Mouse-Unit-07/hardware-motherboard/README.md

# Hardware Motherboard

- Hardware reference files for the micromouse motherboard
- Includes:
  - Schematic pdf's
  - Layout pdf's
  - Mechanical drawing pdf's
  - Design explanation documentation
