Mouse-Unit-07/hardware-motherboard/design-explanation/power/power-explanation.md

# Power Design Explanation

- Notes regarding motherboard power design choices and specs.

## Index

- [Power Tree Diagram](#power-tree-diagram)
- [3V7 Vacuum Power](#3v7-vacuum-power)
- [12V Wheel Motor Power](#12v-wheel-motor-power)
- [3V3 Power](#3v3-power)
- [5V Power](#5v-power)
- [Switching vs Linear Regulators](#switching-vs-linear-regulators)
- [Battery Selection](#battery-selection)
- [Power Management](#power-management)
- [PCB Traces](#pcb-traces)
- [Electrical Protection](#electrical-protection)
- [Archived Ideas](#archived-ideas)

## Power Tree Diagram

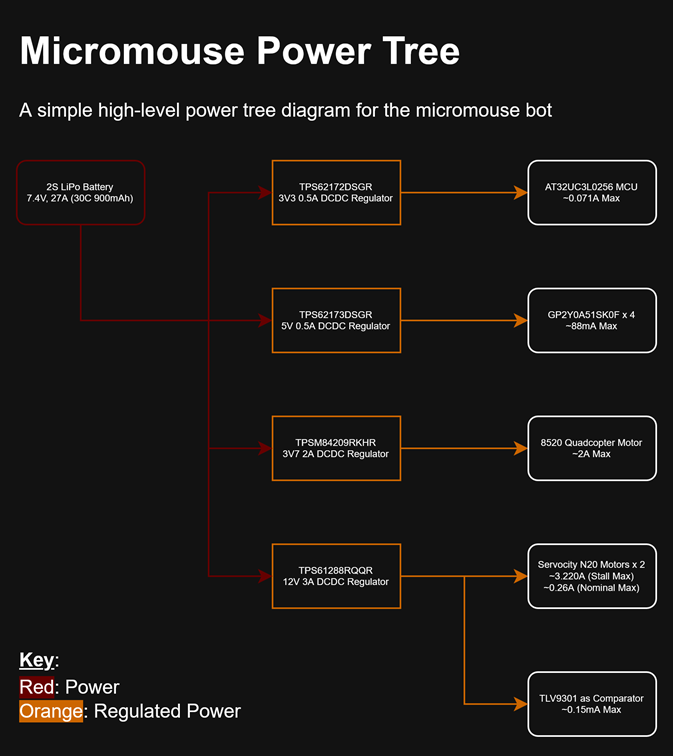
[picture p8: design-explanation/power/_images/power-explanation/micromouse-power-tree.drawio.png]
micromouse-power-tree.drawio
- 
  - Simple/high-level power tree diagram showing battery -> regulators -> components powered

## 3V7 Vacuum Power

- ~2A is ideal for a 8520 quadcopter motor
  - Experiment done here: https://notblackmagic.com/projects/motor-test-stand/
- Regulator selection
  - TI generated circuit: https://webench.ti.com/appinfo/webench/scripts/SDP.cgi?ID=3EACC4ED5253923B
  - 3V7, 2A circuit

## 12V Wheel Motor Power

- ServoCity's [Premium N20 Gear Motor (5:1 Ratio, 4900 RPM, with Encoder)](https://www.servocity.com/4900-rpm-micro-gear-motor-w-encoder/)
  - Demands 1.6A on stall, and 12V nominal
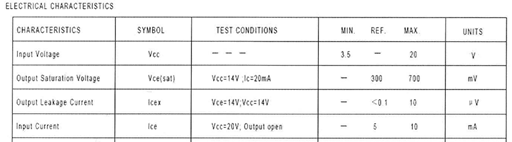
[picture p9: design-explanation/power/_images/power-explanation/servocity-encoder-current.png]
servocity-encoder-current
  - 
    - Encoders demand 10mA max
  - 1.6A * 2 + 10mA * 2 = 3.220A needed
    - ...But this is if we want to consistently support stall current
    - Nominal is much less, at 120mA per motor- there's no need to provide the full 1.6A per motor
- Regulator selection
  - TI generated circuit tool: https://webench.ti.com/appinfo/webench/scripts/SDP.cgi?ID=AA12043C39DD7B4B
  - 12V, 3A circuit

## 3V3 Power

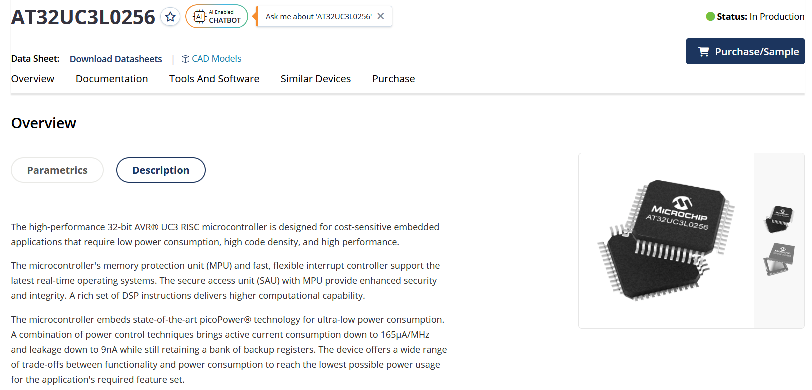
[picture p10: design-explanation/power/_images/power-explanation/at32uc3l0256-current.png]
at32uc3l0256-current
- 
  - Datasheet here: https://ww1.microchip.com/downloads/en/DeviceDoc/Atmel-32145-32-bit-Flash-MCU-UCL0_datasheet.pdf
  - 165uA/MHz at 50MHz is 8.25mA max current draw
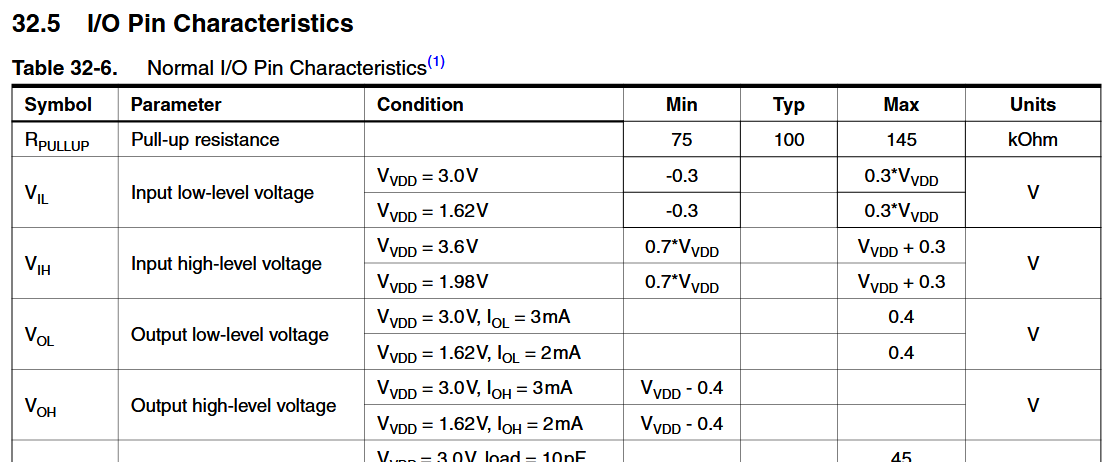
[picture p11: design-explanation/power/_images/power-explanation/at32uc3l0256-io-draw.png]
at32uc3l0256-io-draw
- 
  - IO pins sink 3mA per pin, assuming we're using them safely w/ each device:
    - USART RX, TX
    - LED x4
    - Configuration pushbutton
    - JTAG: TDI, TCK, TDO, TMS
    - Wheel motor drive pins: 4 direction pins + 2 pwm pin, STBY, CLD
    - Vacuum MOSFET drive pin
    - Regulator enable pin
  - 21 pins * 3mA = 63mA total
- Total current:
  - 63mA + 8.25mA = 71.25mA total
- Regulator selection
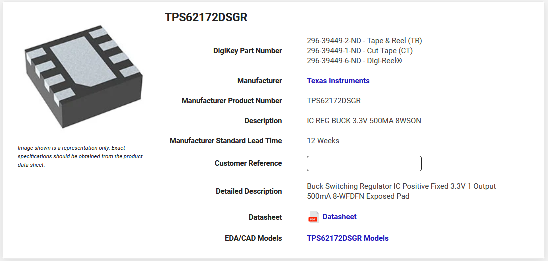
[picture p12: design-explanation/power/_images/power-explanation/3v3-regulator.png]
3v3-regulator
  - 
  - TI's TPS62172DSGR
  - 3V3 500mA switching regulator
  - Datasheet here: [TI Link](https://www.ti.com/lit/ds/symlink/tps62171.pdf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)

## 5V Power

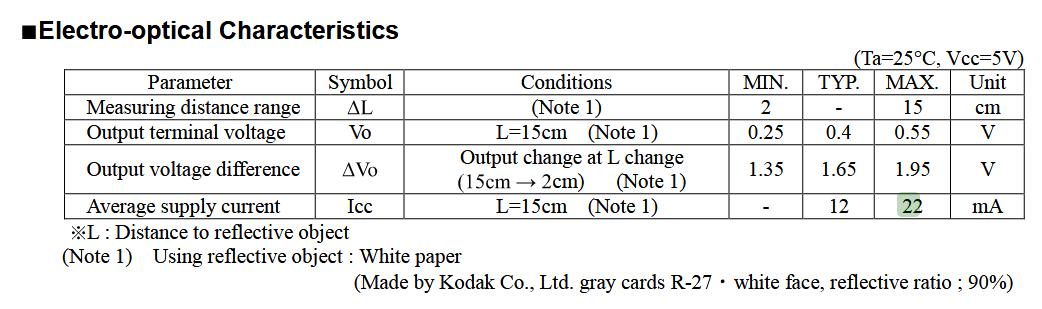
[picture p13: design-explanation/power/_images/power-explanation/GP2Y0A51SK0F-current.png]
GP2Y0A51SK0F-current
- 
  - Each sensor draws 22mA max, so 4 of them makes a total of 88mA max
- Regulator selection
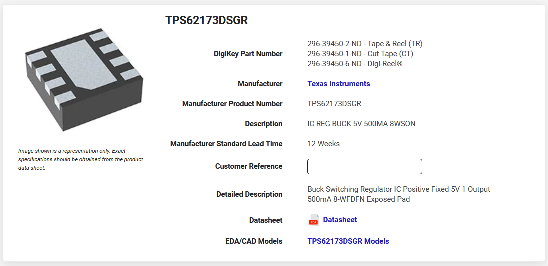
[picture p14: design-explanation/power/_images/power-explanation/5v-regulator.png]
5v-regulator
  - 
  - TI's TPS62173DSGR
  - 5V 500mA switching regulator
  - Datasheet here: [TI Link](https://www.ti.com/lit/ds/symlink/tps62171.pdf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)

## Switching vs Linear Regulators

- Switching regulators are the way to go: https://www.rohm.com/electronics-basics/dc-dc-converters/linear-vs-switching-regulators
  - More details in _The Art of Electronics_ too
- Texas Instruments
  - TI provides a fantastic tool to generate power circuits: https://webench.ti.com/power-designer/switching-regulator
  - TI provides the best datasheets to begin w/ anyway even if you were to manually design a regulator circuit

## Battery Selection

- Battery type
  - LiPo is the best, as per University of Nevada: https://www.physics.unlv.edu/~bill/ecg497/Drew_Tondra_report.pdf
    - Best for performance and rechargeability
    - Smallest form factor 2S LiPo battery chosen on Amazon
    - LiPo analysis video: https://www.youtube.com/watch?v=Lk7wzVYmXSA
    - Understanding LiPo specs: https://www.rchelicopterfun.com/lipo-battery-ratings.html
- Current draw
  - Most RC car LiPo batteries are capable of providing high current
  - We need at least 6A to comfortably drive the micromouse
  - LiPo batteries' capacity multiplier tells us how much current the battery can safely discharge continuously
    - 900 mAh 30C means 27A max current draw
    - 900 mAh at 6A current draw means 9 minutes of activity

```
Total current dischargeable calculation:
900 mAh, 30C rating
900 mA * 30 = 27A dischargeable continuously

Micromouse active time calculation:
900 mAh, 6A draw max
0.9Ah / 6A = 9 minutes
```

## Power Management

- Enable signal
  - Every switching regulator, except the 3V3 regulator, has an enable signal that can be toggled by the MCU
- Battery voltage comparator
  - LM393 dual comparator IC installed for low battery voltage (warning and failure) detection
  - TL431 2.495V voltage reference used for each comparator
  - Each of the comparators light up an indicator LED when thresholds are crossed
  - The failure comparator output is AND'ed w/ a small rocker switch output to drive mouse on/off PMOS- mouse only turns on if battery is OK and rocker switch is in "on" position

```

battery warning threshold comparator voltage divider:
- R1 = 180k, R2 = 100k
Vnode = Vbat * (100 / (180 / 100)) = 0.357 * Vbat
2.495V reference / 0.357 = 6.9V warning threshold

battery failure threshold comparator voltage divider:
- R1 = 160k, R2 = 100k
Vnode = Vbat * (100 / (160 / 100)) = 0.384 * Vbat
2.495V reference / 0.384 = 6.487V failure threshold

```

## PCB Traces

- Even if your regulator circuit can provide 5A, 35 mil traces can only carry 3A
- Use Saturn PCB Design tool to ensure that traces are wide enough to carry the desired current

## Electrical Protection

- TVS clamping diode
  - "transient voltage suppression" diode installed across entire mouse / battery to clamp
  - 10V reverse standoff, 11.1V breakdown, 35.3A, 600W diode clamps any spikes
- PMOS high-side "power pak" load switch
  - Load switch to the entire mouse for smooth on/off, reverse polarity protection
  - Handles up to -20V Vds max, 35A
  - This allows us to avoid a physical high DC current switches to turn on the whole mouse
  - Zener diode installed from source to gate to clamp up to 12V on Vgs
- Battery to regulator input diode
  - IEEE Berkely mentions they encountered an issue w/ current flowing from MCU to regulator: https://ieee.berkeley.edu/micromouse-lab-5/
  - Added to prevent reverse current from regulator to battery
  - 1V voltage drop, 6A standard rectifier between battery and all switching regulators
- Multi-Stage decoupling
  - Varying capacitors of differing capacitance to absorb noise and suppress spikes
  - Low capacitance -> high frequency spikes
  - High capacitance -> low frequency bulk decoupling
- Flyback diodes
  - Why we need these
    - Inductors store energy in a magnetic field while current flows
    - Turning off a motor causes the motor's magnetic field to collapse
    - Inductors resist changes in current, and try to keep current flowing- this causes high voltage spike in the reverse direction across the inductor
    - To safely dissipate excess power, there needs to be a diode that breaks down in response to such spikes
  - Diode selection
    - Breakdown voltage of 2-3 times normal voltage is good
    - Schottky diodes are good for
      - Low forward drop
      - Less heating
      - Faster recovery time if switching is fast
- Order of connecting components to ground
  - Electronics stack exchange thread: https://electronics.stackexchange.com/questions/458538/feeding-microcontroller-and-linear-actuators-motors-with-the-same-power-supply
  - Noisy components should be as close as possible to the power supply ground to mitigate ground loops and noise
- Fuse
  - 10A fuse for entire mouse, provided a rough 6A consumption max
  - 125% of circuit's normal operating current is good rule of thumb
- Bulk capacitor
  - 470uF 25V bulk capacitor x2 for entire mouse
  - Good rule of thumb is:
    - 100uF per A of max load current for general cases
    - 200~470uF per A for high-power and noisier circuits

## Archived Ideas

- Full-on BMS circuit
  - Would be cool to get battery SOH and SOC w/ coulomb counting IC, but requires more hardware and involved schemes
  - Archived due to complexity
- Current & voltage monitoring
  - Requires more pins from MCU and extra hardware (shunt resistors, sensing IC's)
  - Archived for now until crucial features are complete
