Mouse-Unit-07/hardware-motherboard/design-explanation/_images/overview/Mouse 7.0 3D render.png

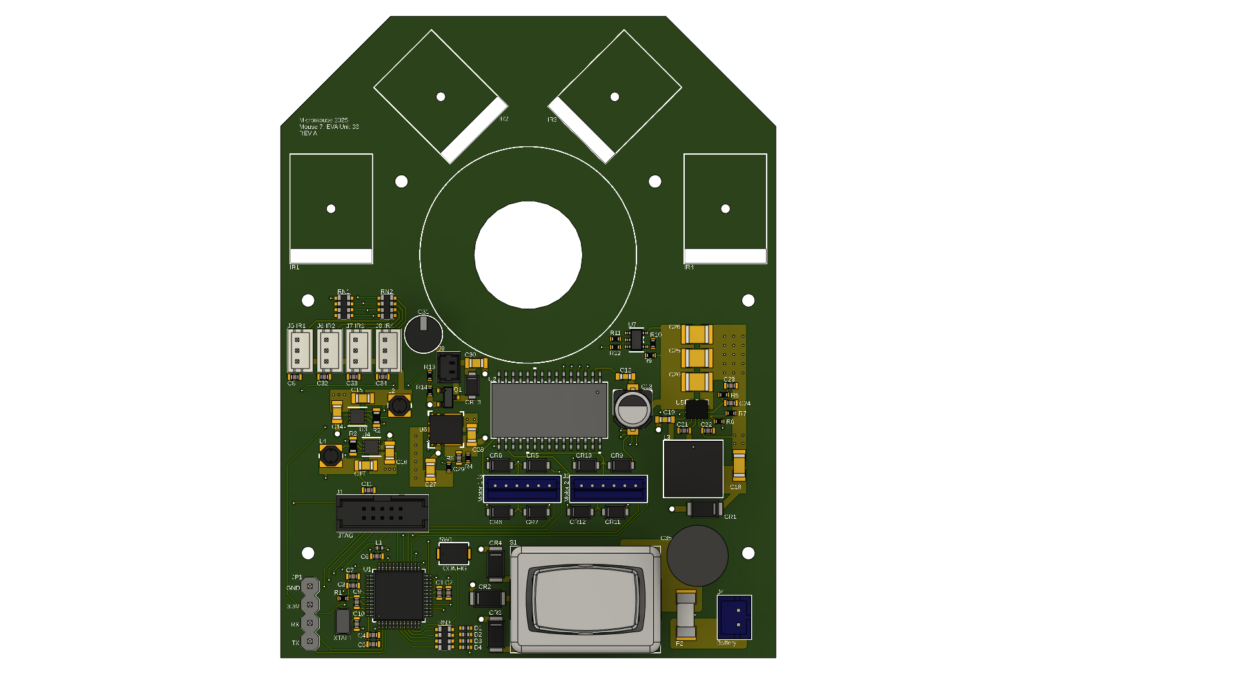
design-explanation/_images/overview/Mouse 7.0 3D render.png
