Mouse-Unit-07/hardware-motherboard/design-explanation/_images/overview/power-circuit.png

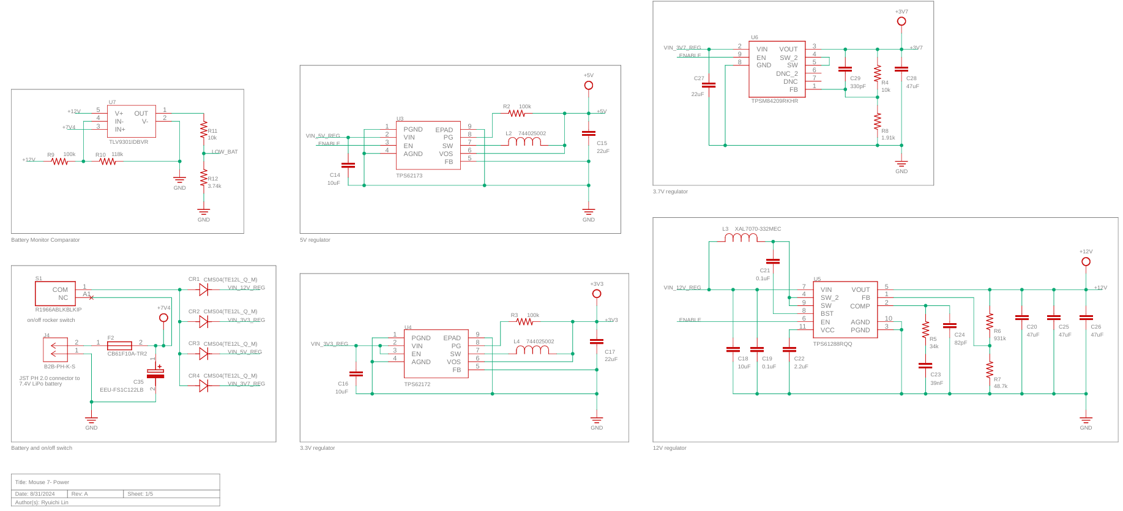
design-explanation/_images/overview/power-circuit.png
