Mouse-Unit-07/hardware-motherboard/design-explanation/_images/overview/vacuum-motor-driver-circuit.png

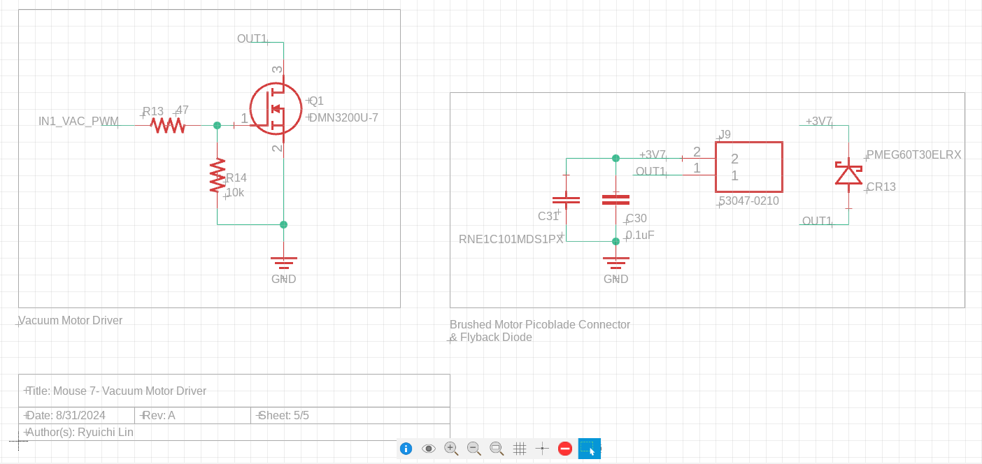
design-explanation/_images/overview/vacuum-motor-driver-circuit.png
