Mouse-Unit-07/hardware-motherboard/design-explanation/_images/overview/wheel-motor-driver.png

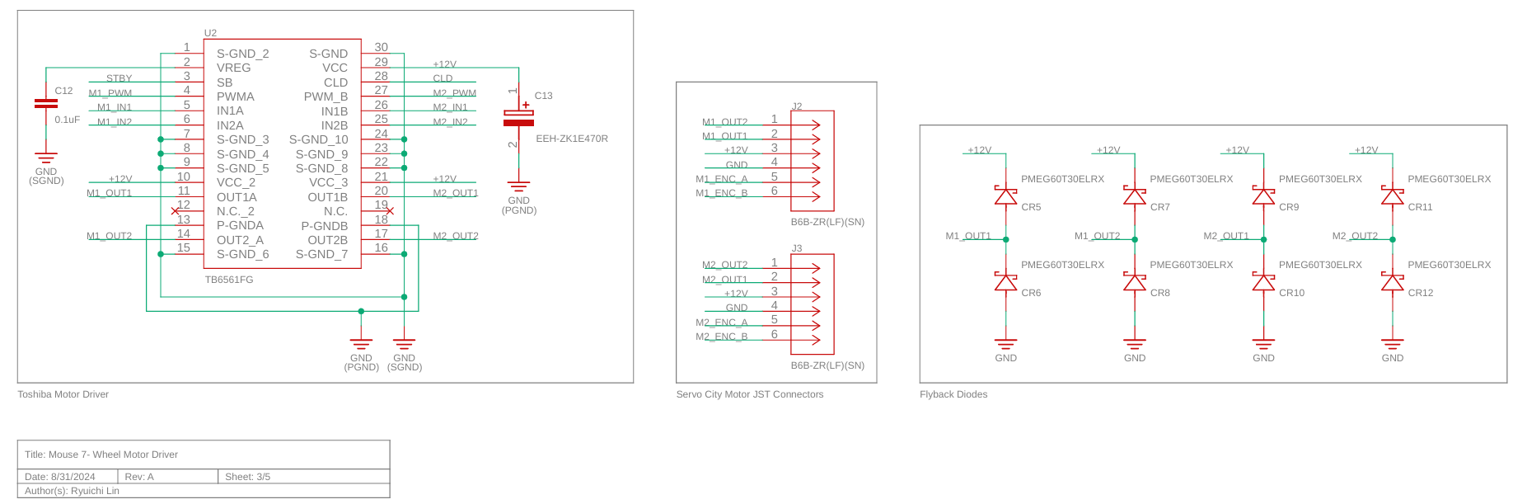
design-explanation/_images/overview/wheel-motor-driver.png
