Mouse-Unit-07/hardware-motherboard/design-explanation/infrared-sensors/_images/infrared-sensor-explanation/sharp-sensor-output-graph.png

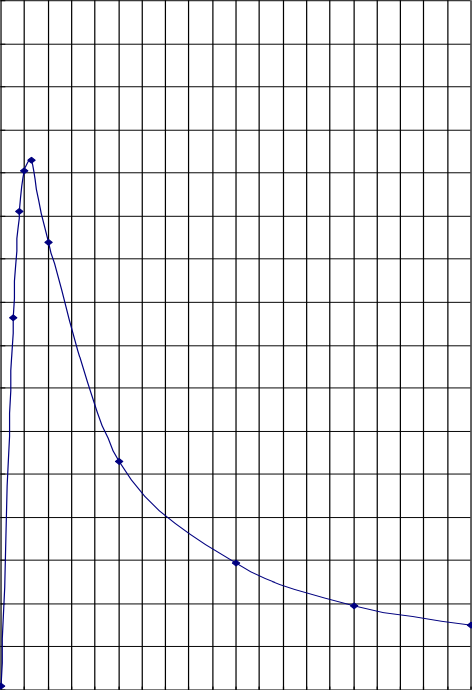
design-explanation/infrared-sensors/_images/infrared-sensor-explanation/sharp-sensor-output-graph.png
