Mouse-Unit-07/hardware-motherboard/bill-of-materials/motherboard-BOM.csv

Category | Vendor | Item Number | Item Description | Quantity Per Package | Cost Per Package | Number of Packages | Item Total Cost | Part Link | Symbol, Layout, & 3D Model Link | Comments | Designation on Mouse 7.0 Test | Designation on Mouse 7.0 PCB
Power | Amazon | B096G4D6ZX | URGENEX 7.4V Lipo Battery 2S 30C 900mAh Rechargeable Lipo Battery with PH2.0 Plug Compatible with Most 1/10, 1/16, 1/18, 1/24 Scale RC Cars Trucks | 2 | $19.99 | 1 | $19.99 | https://www.amazon.com/URGENEX-Battery-900mAh-Rechargeable-Campatibal/dp/B096G4D6ZX |  | - 7.4V LiPo battery, 900mAh, 46g, 30C - JST PH 2.0 pitch 2 position for power, 3 position for charging - 53mm x 16mm x 29mm (l x h x w)
 | Amazon | B01MCZE2HM | 460pcs 2.54mm JST-XH Connector Kit with 2.54mm Female Pin Header and 2/3 / 4/5 / 6 Pin Housing Connector Adapter Plug (JST Connector Kit) | 460 | $10.99 | 1 | $10.99 | https://amazon.com/gp/product/B01MCZE2HM/ref=ppx_yo_dt_b_search_asin_title?ie=UTF8&psc=1 | https://app.ultralibrarian.com/details/cd91410a-50c2-11eb-9033-0a34d6323d74/JST/B3B-XH-A-LF-SN-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 | - XH 2.54mm JST connector 3 position pack both male and female TH - need the female connector | new
 | Digikey | CMS04(TE12LQM)CT-ND | DIODE SCHOTTKY 30V 5A M-FLAT | 1 | $0.76 | 4 | $3.04 | https://www.digikey.com/en/products/detail/toshiba-semiconductor-and-storage/CMS04-TE12L-Q-M/871534 | https://app.ultralibrarian.com/details/873d4c59-1bbb-11ea-a124-0ad2c9526b44/Toshiba-Electronic-Devices-Storage-Corp-/CMS04-TE12L-Q-M-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 | - schottky diode for everything except vacuum that needs 5A - prevents up to 30V and allows 5A to pass - for 3.3V, 5V, 12V, and 3.2V regulators - small 370mV forward drop
 | Digikey | 296-53563-1-ND | DC DC CONVERTER 1.2-6V | 1 | $3.48 | 1 | $3.48 | https://www.digikey.com/en/products/detail/texas-instruments/TPSM84209RKHR/10273205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 | https://app.ultralibrarian.com/details/72767a0a-9a13-11e9-ab3a-0a3560a4cccc/Texas-Instruments/TPSM84209RKHR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 | - 3.7V 2A regulator for vacuum motor - schematic generated w/ TI tool: HERE HERE
 | Digikey | 445-7665-1-ND | CAP CER 22UF 10V X5R 0805 | 1 | $0.39 | 1 | $0.78 | https://www.digikey.com/en/products/detail/tdk-corporation/C2012X5R1A226M125AB/2733100 | n/a | - Cin for vacuum fan regulator circuit - 0805 package - 22uF
 | Digikey | 445-8239-1-ND | CAP CER 47UF 10V X5R 0805 | 1 | $0.79 | 1 | $2.37 | https://www.digikey.com/en/products/detail/tdk-corporation/C2012X5R1A476M125AC/2812455 | n/a | - Cout for vacuum fan regulator circuit - 0805 package - 47uF
 | Digikey | 399-C0402C331J5JAC7867CT-ND | CAP CER 330PF 50V U2J 0402 | 1 | $0.24 | 1 | $0.24 | https://www.digikey.com/en/products/detail/kemet/C0402C331J5JAC7867/6176500 | n/a | - Cff for vacuum fan regulator circuit - 0402 package - 330pF
 | Digikey | 541-10.0KLCT-ND | RES SMD 10K OHM 1% 1/16W 0402 | 1 | $0.10 | 1 | $0.10 | https://www.digikey.com/en/products/detail/vishay-dale/CRCW040210K0FKED/1178121 | n/a | - Rfbt for vacuum fan regulator circuit - 0402 package - 10k Ohm resistor
 | Digikey | 541-1.91KLCT-ND | RES SMD 1.91K OHM 1% 1/16W 0402 | 1 | $0.10 | 1 | $0.10 | https://www.digikey.com/en/products/detail/vishay-dale/CRCW04021K91FKED/1178037 | n/a | - Rfbb for vacuum fan regulator circuit - 0402 package - 1.91k Ohm resistor
 | Digikey | 296-TPS61288RQQRCT-ND | IC REG BOOST ADJ 15A 11VQFN | 1 | $5.89 | 1 | $5.89 | https://www.digikey.com/en/products/detail/texas-instruments/TPS61288RQQR/13627146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 | https://app.ultralibrarian.com/details/b8fe61ee-f9ad-11ea-b55a-0a34d6323d74/Texas-Instruments/TPS61288RQQR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 | - 12V 3A regulator for wheel motor driver - schematic generated w/ TI tool: https://webench.ti.com/appinfo/webench/scripts/SDP.cgi?ID=AA12043C39DD7B4B
 | Digikey | 445-4042-1-ND | CAP CER 10UF 16V X7R 1206 | 1 | $0.30 | 1 | $0.30 | https://www.digikey.com/en/products/detail/tdk-corporation/C3216X7R1C106K160AC/1965630 | n/a | - Cin for wheel motor regulator circuit - 1206 package - 10uF
 | Digikey | 445-1314-1-ND | CAP CER 0.1UF 50V X7R 0603 | 1 | $0.10 | 1 | $0.10 | https://www.digikey.com/en/products/detail/tdk-corporation/C1608X7R1H104K080AA/513811 | n/a | - Cinx for wheel motor regulator circuit - 0603 package - 0.1uF
 | Coilcraft | XAL7070-332 | XAL7070-332MEC | 1 | $3.25 | 1 | $3.25 | https://www.coilcraft.com/en-us/products/power/shielded-inductors/molded-inductor/xal/xal7070/xal7070-332/ | https://app.ultralibrarian.com/details/c70f84e9-0c17-11ee-9288-0ae0a3b49db5/Coilcraft/XAL7070-332MEC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 | - L1 for wheel motor regulator circuit
 | Digikey | 445-4952-1-ND | CAP CER 0.1UF 16V X7R 0402 | 1 | $0.10 | 1 | $0.10 | https://www.digikey.com/en/products/detail/tdk-corporation/C1005X7R1C104K050BC/2093220 | n/a | - Cbst for wheel motor regulator circuit - 0402 package - 0.1uF
 | Digikey | 445-9097-1-ND | CAP CER 2.2UF 10V X7S 0402 | 1 | $0.29 | 1 | $0.29 | https://www.digikey.com/en/products/detail/tdk-corporation/C1005X7S1A225K050BC/3661557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 | n/a | - Cvcc for wheel motor regulator circuit - 0402 package - 2.2uF
 | Digikey | 541-34.0KLCT-ND | RES SMD 34K OHM 1% 1/16W 0402 | 1 | $0.10 | 1 | $0.10 | https://www.digikey.com/en/products/detail/vishay-dale/CRCW040234K0FKED/1178180 | n/a | - Rcomp for wheel motor regulator circuit - 0402 package - 34k Ohms
 | Digikey | 490-16432-1-ND | CAP CER 0.039UF 16V X7R 0402 | 1 | $0.10 | 1 | $0.10 | https://www.digikey.com/en/products/detail/murata-electronics/GCM155R71C393KA37D/7363176 | n/a | - Ccomp for wheel motor regulator circuit - 0402 package - 39nF
 | Digikey | 399-11256-1-ND | CAP CER 82PF 25V C0G/NP0 0402 | 1 | $0.49 | 1 | $0.49 | https://www.digikey.com/en/products/detail/kemet/CBR04C820F3GAC/4377017 | n/a | - Ccomp2 for wheel motor regulator circuit - 0402 package - 82pF
 | Digikey | 541-931KLCT-ND | RES SMD 931K OHM 1% 1/16W 0402 | 1 | $0.10 | 1 | $0.10 | https://www.digikey.com/en/products/detail/vishay-dale/CRCW0402931KFKED/1178346 | n/a | - Rfbt for wheel motor regulator circuit - 0402 package - 931k Ohms
 | Digikey | 541-48.7KLCT-ND | RES SMD 48.7K OHM 1% 1/16W 0402 | 1 | $0.10 | 1 | $0.10 | https://www.digikey.com/en/products/detail/vishay-dale/CRCW040248K7FKED/1178199 | n/a | - Rfbb for wheel motor regulator circuit - 0402 package - 48.7k Ohms
 | Digikey | 490-16309-1-ND | CAP CER 47UF 16V X6S 1210 | 1 | $0.52 | 3 | $1.56 | https://www.digikey.com/en/products/detail/murata-electronics/GRM32EC81C476KE15K/7363053 | n/a | - Cout for wheel motor regulator circuit - 1210 package - 47uF
 | Digikey | 563-1943-ND | SWITCH ROCKER SPDT 0.4VA 28V | 1 | $3.33 | 1 | $3.33 | https://www.digikey.com/en/products/detail/nidec-components/CF-LD-1DC-AR2W/6008982 | https://app.ultralibrarian.com/details/ee126dc9-75f1-11eb-9033-0a34d6323d74/Nidec-Copal-Electronics/CF-LD-1DC-AR2W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 | - rocker switch for on/off of entire mouse - open-drain w/ pull-up to be AND'ed w/ battery comparator before switching on the mouse PMOS | new
 | Digikey | 283-5179-1-ND | FUSE BRD MNT 10A 125VAC/VDC 2SMD | 1 | $0.91 | 1 | $0.91 | https://www.digikey.com/en/products/detail/eaton-electronics-division/CB61F10A-TR2/3526138 | https://www.mouser.com/ProductDetail/Bussmann-Eaton/CB61F10A-TR2?qs=3W28jC%252BmlM2sYw8RFxQ%2Faw%3D%3D | - 10A fuse for entire mouse - 3A for wheels + 2A for vacuum + 1A for 3.3V + 1A for 5V = 7A
 | Digikey | EEE-FT1E471GP | CAP ALUM 470UF 20% 25V SMD | 1 | $1.30 | 2 | $2.60 | https://www.digikey.com/en/products/detail/panasonic-industry/EEE-FT1E471GP/6048928 | https://app.ultralibrarian.com/details/e4f2a1ee-e257-11ea-8aae-0a34d6323d74/Panasonic/EEH-ZK1E470R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 | - 470uF 25V bulk cap x2 for entire mouse | new
 | Digikey | SMBJ10A-E3/52 | TVS DIODE 10VWM 17VC DO214AA | 1 | $0.56 | 1 | $0.56 | https://www.digikey.com/en/products/detail/vishay-general-semiconductor-diodes-division/SMBJ10A-E3-52/1119202 | https://app.ultralibrarian.com/details/73ddbba1-da83-11eb-9033-0a34d6323d74/Vishay/SMBJ100A-E3-52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 | - 10V reverse standoff, 11.1V breakdown, 35.3A, 600W clamping diode for entire mouse and battery | new
 | Digikey | SI7129DN-T1-GE3 | MOSFET P-CH 30V 35A PPAK1212-8 | 1 | $1.62 | 1 | $1.62 | https://www.digikey.com/en/products/detail/vishay-siliconix/SI7129DN-T1-GE3/2622439 | https://app.ultralibrarian.com/details/ff9c0d9f-480b-11ec-9033-0a34d6323d74/Vishay/SI7129DN-T1-GE3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 | - PMOS "power pak" load switch to the entire mouse for clean on/off, reverse polarity protection | new
 | Digikey | SZMM5Z12VST5G | DIODE ZENER 12V 500MW SOD523 | 1 | $0.23 | 1 | $0.23 | https://www.digikey.com/en/products/detail/onsemi/SZMM5Z12VST5G/25602310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 | https://app.ultralibrarian.com/details/dfcd6d67-c043-11eb-9033-0a34d6323d74/onsemi/SZMM5Z10VT1G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 | - Zener diode placed from mouse on/off PMOS source to gate for protection | new
 | Digikey | 445-9086-1-ND | CAP CER 1UF 16V X6S 0402 | 1 | $0.10 | 1 | $0.10 | https://www.digikey.com/en/products/detail/tdk-corporation/C1005X6S1C105K050BC/3661565 | n/a | - 1uF 0402 used to smooth mouse on/off PMOS gate | new
 | Digikey | 296-39450-1-ND | IC REG BUCK 5V 500MA 8WSON | 1 | $1.36 | 1 | $1.36 | https://www.digikey.com/en/products/detail/texas-instruments/TPS62173DSGR/2833458 | https://app.ultralibrarian.com/details/16ac426d-103f-11e9-ab3a-0a3560a4cccc/Texas-Instruments/TPS62173DSGR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 | - 5V, 500mA switching regulator - used to power Sharp sensors
 | Digikey | 296-39449-1-ND | IC REG BUCK 3.3V 500MA 8WSON | 1 | $1.36 | 1 | $1.36 | https://www.digikey.com/en/products/detail/texas-instruments/TPS62172DSGR/2833456 | https://app.ultralibrarian.com/details/16ac3ea9-103f-11e9-ab3a-0a3560a4cccc/Texas-Instruments/TPS62172DSGR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 | - 3.3V, 500mA switching regulator - used to power MCU
 | Digikey | 445-6857-1-ND | CAP CER 10UF 10V X7R 0805 | 1 | $0.31 | 2 | $0.62 | https://www.digikey.com/en/products/detail/tdk-corporation/C2012X7R1A106K125AC/2619198 | n/a | - 10uF ceramic cap needed for 5V and 3.3V switching regulator - between VIN and PGND (pg 21 pdf of datasheet) - 0805 package
 | Digikey | 445-7665-1-ND | CAP CER 22UF 10V X5R 0805 | 1 | $0.39 | 2 | $0.78 | https://www.digikey.com/en/products/detail/tdk-corporation/C2012X5R1A226M125AB/2733100 | n/a | - 22uF ceramic cap needed for 5V and 3.3V switching regulator - between SW and FB (pg 21 pdf of datasheet)
 | Digikey | 541-100KHCT-ND | RES SMD 100K OHM 1% 1/10W 0603 | 1 | $0.10 | 2 | $0.20 | https://www.digikey.com/en/products/detail/vishay-dale/CRCW0603100KFKEA/1174896 | n/a | - 100k Ohm resistor needed for 5V and 3.3V switching regulator - between SW/VOS and PG (pg 21 pdf of datasheet) - smaller 0603 package
 | Digikey | 732-2613-1-ND | FIXED IND 2.2UH 1.8A 66 MOHM SMD | 1 | $1.64 | 2 | $3.28 | https://www.digikey.com/en/products/detail/w%C3%BCrth-elektronik/744025002/2445620 | https://www.mouser.com/ProductDetail/Wurth-Elektronik/744025002?qs=rS3zZhy2AQOJdJOD4WhGug%3D%3D | - 2.2uH inductor needed for 5V and 3.3V switching regulator - between SW and 100k Ohm resistor (pg 21 pdf of datasheet)
 | Digikey | LM393BIDDFR | IC COMPARATOR 2 GEN PUR TSOT23-8 | 1 | $0.24 | 2 | $0.48 | https://www.digikey.com/en/products/detail/texas-instruments/LM393BIDDFR/13535444 | https://app.ultralibrarian.com/details/41f68c4c-e3b2-11ea-8aae-0a34d6323d74/Texas-Instruments/LM393BIDDFR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 | - 2-36V dual comparator IC for low battery voltage (warning and failure) detection - failure comparator output is AND'ed w/ rocker switch output to drive mouse on/off PMOS | new
 | Digikey | 445-4952-1-ND | CAP CER 0.1UF 16V X7R 0402 | 1 | $0.10 | 1 | $0.10 | https://www.digikey.com/en/products/detail/tdk-corporation/C1005X7R1C104K050BC/2093220 | n/a | - 0.1uF cap for comparator vcc | new (dupe)
 | Digikey | TL431AIDBZR | IC VREF SHUNT ADJ 1% SOT23-3 | 1 | $0.29 | 1 | $0.29 | https://www.digikey.com/en/products/detail/texas-instruments/TL431AIDBZR/686856 | https://app.ultralibrarian.com/details/16778844-103f-11e9-ab3a-0a3560a4cccc/Texas-Instruments/TL431AIDBZR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 | - 2.495V voltage reference for LM393 comparator
 | Digikey | 541-10.0KLCT-ND | RES SMD 10K OHM 1% 1/16W 0402 | 1 | $0.10 | 1 | $0.10 | https://www.digikey.com/en/products/detail/vishay-dale/CRCW040210K0FKED/1178121 | n/a | - 10k Ohm 0402 resistor for voltage reference pull-up | new (dupe)
 | Digikey | 445-4952-1-ND | CAP CER 0.1UF 16V X7R 0402 | 1 | $0.10 | 1 | $0.10 | https://www.digikey.com/en/products/detail/tdk-corporation/C1005X7R1C104K050BC/2093220 | n/a | - 0.1uF cap for voltage reference output | new (dupe)
 | Digikey | SG73P1JTTD104J | RES 100K OHM 5% 1/3W 0603 | 1 | $0.11 | 2 | $0.22 | https://www.digikey.com/en/products/detail/koa-speer-electronics-inc/SG73P1JTTD104J/10190103 | n/a | - 100k 0603 pullup for mouse on/off rocker switch and mouse on/off AND_NODE inverting NMOS | new
 | Digikey | RCS0402100KFKED | RES 100K OHM 1% 1/3W 0402 | 1 | $0.12 | 4 | $0.48 | https://www.digikey.com/en/products/detail/vishay-dale/RCS0402100KFKED/5867045 | n/a | - 100k 0402 Vout pullup and voltage divider R2 for battery voltage comparators | new
 | DIgikey | RCS04022M20FKED | RES 2.2M OHM 1% 1/3W 0402 | 1 | $0.13 | 2 | $0.26 | https://www.digikey.com/en/products/detail/vishay-dale/RCS04022M20FKED/12446349 | n/a | - 2.2M Ohm 0402 feedback resistor for each comparator | new
 | Digikey | 541-10.0KLCT-ND | RES SMD 10K OHM 1% 1/16W 0402 | 1 | $0.10 | 2 | $0.20 | https://www.digikey.com/en/products/detail/vishay-dale/CRCW040210K0FKED/1178121 | n/a | - 10k Ohm 0402 resistor for battery comparator warning and failure indicator LEDs | new (dupe)
 | Digikey | RCS0402180KFKED | RES 180K OHM 1% 1/3W 0402 | 1 | $0.13 | 1 | $0.13 | https://www.digikey.com/en/products/detail/vishay-dale/RCS0402180KFKED/5867941 | n/a | - 180k Ohm 0402 resistor for warning battery comparator voltage divider R1 | new
 | Digikey | ERJ-PA2F1603X | RES 160K OHM 1% 1/5W 0402 | 1 | $0.21 | 1 | $0.21 | https://www.digikey.com/en/products/detail/panasonic-industry/ERJ-PA2F1603X/9814976 | n/a | - 160k Ohm 0402 resistor for failure battery comparator voltage divider R1 | new
 | Digikey | 2N7002-7-F | MOSFET N-CH 60V 115MA SOT23-3 | 1 | $0.20 | 1 | $0.20 | https://www.digikey.com/en/products/detail/diodes-incorporated/2N7002-7-F/717681 | https://app.ultralibrarian.com/details/465b5e17-1794-11ed-b159-0a34d6323d74/Diodes-Inc/2N7002AQ-7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 | - 2N7002 NMOS to invert the open-drain AND_NODE and turn on the mouse on/off PMOS when both rocker switch and battery comparator output HIGH | new
Wheel Motor Related | Digikey | TB6561FG8ELCT-ND | IC MOTOR DRIVER 10V-36V 30SSOP | 1 | $3.51 | 1 | $3.51 | https://www.digikey.com/en/products/detail/toshiba-semiconductor-and-storage/TB6561FG-8-EL/1730056 | https://app.ultralibrarian.com/details/84a3ee1c-5a2c-11eb-9033-0a34d6323d74/Toshiba-Electronic-Devices-Storage-Corp-/TB6561FG-8-EL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 | - H bridge PWM interface brushed motor driver - 10-36V supply, 3A output max, 30-BSOP
 | Digikey | 445-7456-1-ND | CAP CER 0.1UF 50V X5R 0603 | 1 | $0.11 | 1 | $0.11 | https://www.digikey.com/en/products/detail/tdk-corporation/C1608X5R1H104K080AA/2732891 | n/a | - C2 0.1uF cap for 5V output from motor driver - datasheet pg 8: HERE - 0603 package
 | Digikey | P121394CT-ND | CAP ALUM HYB 47UF 20% 25V SMD | 1 | $1.45 | 1 | $1.45 | https://www.digikey.com/en/products/detail/panasonic-electronic-components/EEH-ZK1E470R/6564642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 | https://www.mouser.com/ProductDetail/Panasonic/EEH-ZK1E470R?qs=FNcb6ahWXRxnLCe3Ulph5A%3D%3D | - C1 47uF polymer cap for motor driver supply - datasheet pg 8
 | Servocity | 638103 | Gear Motor with Encoder | 1 | $19.99 | 2 | $39.98 | https://www.servocity.com/4900-rpm-micro-gear-motor-w-encoder/ |  | - Gear motors, 4900rpm w/ encoders - 6 position 1.5 pitch ZH JST
 | Amazon | ASIN: B0D8PS1X3D | 1000 Pcs Tiny Screws for Electronics, M1.6 M1.7 M2 M2.5 M3 Round Head Mini, Replacement Computer Screws, Small Machine Assortment Kit for Laptop Notebook Glasses Repair(1000) | 50 | $8.98 | 1 | $8.98 | https://www.amazon.com/woshilaoDS-Electronics-Replacement-Computer-Assortment/dp/B0D8PS1X3D |  | - M1.6 screws for mounting gear motor to 3D printed mounts - Also for mounting 3D mounts to PCB | new
 | Amazon | B07KY8GK5W | uxcell 10pcs Round Steel Metal Rods, 3mm x 100mm High Speed Steel (HSS) Lathe Bar Stock Tool, for Shaft Gear Drill Lathes Boring Machine Turning Miniature DIY Craft, 10pcs | 10 | $7.49 | 1 | $7.49 | https://www.amazon.com/uxcell-Lathe-Round-Solid-Length/dp/B07KY8GK5W |  | - 3mm shafts to loosen the driving gear before attaching to gear motor | new
 | Pololu | 1087 | Black plastic wheels with silicone tires | 2 | $4.95 | 1 | $4.95 | https://www.pololu.com/product/1087 |  | - Wheels, 32mm diameter, 3mm D output shaft - we'll use just the rubber tire and make a custom wheel
 | Amazon | B09NCCXPGM | CQRobot 100 Sets/800 Pieces 1.5 mm Pitch JST ZH 6-Pin IC Sockets & Plugs Adapter Connector Male and Female Terminal, Crimp DIP Kit. for Industrial Integrated Circuit JST Connector Cable. | 100 | $9.58 | 1 | $9.58 | https://www.amazon.com/CQRobot-Connector-Terminal-Industrial-Integrated/dp/B09NCCXPGM | https://www.jst-mfg.com/product/index.php?series=290 https://app.ultralibrarian.com/details/6e868fff-65ca-11eb-9033-0a34d6323d74/JST/B6B-ZR-LF-SN-?uid=248825 | - JST ZH 6 position male (receptacle) TH connector
 | Amazon | B07FW18RQY | uxcell 683ZZ Ball Bearing 3mm x 7mm x 3mm Double Shielded Deep Groove Bearings, Carbon Steel 20pcs | 20 | $7.99 | 4 | $7.99 | https://www.amazon.com/uxcell-Bearing-Double-Shielded-Bearings/dp/B07FW18RQY?rnid=2470954011&rps=1 |  | - 3mm ball bearings to be embedded into custom wheels
 | Amazon | B0BKRQSMFL | FOLIV 700PCS M3 x 5/6/8/10/12/14/16/18/20/25/30mm Button Hex Head Cap Screws M3 Metric Machine Screws Bolts Nuts Washer Assortment Kit, 10.9 Grade Alloy Steel | 10-50 | $15.29 | 1 | $15.29 | https://www.amazon.com/gp/product/B0BKRQSMFL/ref=ox_sc_act_title_1?smid=A3ILXS83DKRO8O&th=1 |  | - M3 button head screws to serve as wheel axels
 | Digikey | 1727-7806-1-ND | DIODE SCHOTTKY 60V 3A SOD123W | 1 | $0.39 | 8 | $3.12 | https://www.digikey.com/en/products/detail/nexperia-usa-inc/PMEG60T30ELRX/9086223 | https://app.ultralibrarian.com/details/785255d6-6dbf-11ee-9288-0ae0a3b49db5/Nexperia/PMEG60T30ELRX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 | - Flyback diodes for EMF protection
 | Digikey | 1772-4071-ND | ROUND SPACER M3 SS 2MM | 1 | $1.51 | 4 | $6.04 | https://www.digikey.com/en/products/detail/raf-electronic-hardware/M0501-3-SS/10073266 |  | - M3 2mm thick spacers to put between wheel and mount - 4.5mm diameter
 | Pololu | 3407 | Silicone Tire Pair for 32×7mm Pololu Wheels | 2 | $2.35 | 4 | $4.70 | https://www.pololu.com/product/3407 | n/a | - 32mm diameter tires
Vacuum Fan Related | Amazon | B08RMQP6YP | 1.25mm Male and Female Connectors Socket and Plug with Pre-Crimped Cables Compatible with JST Molex PicoBlade 1.25 for Pixhawk Silicone 13cm Wire (Male and Female) | 20 | $18.99 | 1 | $18.99 | https://www.amazon.com/Connectors-Pre-Crimped-Compatible-PicoBlade-Silicone/dp/B08RMQP6YP | n/a | - Molex picoblade connector various positions, - includes 3 position 1.25mm pitch male and female connector, 20 of each - includes 10cm precrimped wire - to be used to extend HGLRC wire
 | Digikey | DMN3200U-7DICT-ND | MOSFET N-CH 30V 2.2A SOT23-3 | 1 | $0.45 | 1 | $0.45 | https://www.digikey.com/en/products/detail/diodes-incorporated/DMN3200U-7/1778821 | https://www.mouser.com/ProductDetail/Diodes-Incorporated/DMN3200U-7?qs=oDfC%252BbpzniwrIf3%2FMV01IQ%3D%3D | - 2.2A 30V MOSFET to switch on/off regulator power to vacuum fan
 | Digikey | P17216CT-ND | RES 47 OHM 1% 1/4W 0402 | 1 | $0.23 | 1 | $0.23 | https://www.digikey.com/en/products/detail/panasonic-electronic-components/ERJ-PA2F47R0X/5402642 | n/a | - 47 Ohm gate resistor for MOSFET to limit surge curernt
 | Digikey | 541-10.0KLCT-ND | RES SMD 10K OHM 1% 1/16W 0402 | 1 | $0.10 | 1 | $0.10 | https://www.digikey.com/en/products/detail/vishay-dale/CRCW040210K0FKED/1178121 | n/a | - 10k Ohm resistor for pulling down input to MOSFET to ensure low - 0402 package
 | Digikey | 493-3813-1-ND | RNE1C101MDS1PX | 1 | $0.76 | 1 | $0.76 | https://www.digikey.com/en/products/detail/nichicon/RNE1C101MDS1PX/2239221 | https://app.ultralibrarian.com/details/8611d1e7-1076-11e9-ab3a-0a3560a4cccc/Nichicon/RNE1C101MDS1PX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 | 100uF capacitor for vacuum fan driver
 | Digikey | 4988-NMC0805X7R104K50TRPFCT-ND | CAP SMT08050.1F50VDC | 1 | $0.24 | 1 | $0.24 | https://www.digikey.com/en/products/detail/nic-components-corp/NMC0805X7R104K50TRPF/18895932 | n/a | - 0.1uF cap for brushless motor driver - 0805 package
 | Amazon | B07CFQMF1M | 8pcs 8520 Motor 8.5x20mm 15000KV Brushed Motors 4CW 4CCW Coreless Motor with JST-1.25 Connector for D JI Ryze Tello 720P Camera WiFi FPV RC Quadcopter M80S E013 Plus Tiny 8X Frame Kit etc | 8 | $18.99 | 1 | $18.99 | https://www.amazon.com/8-5x20mm-15000KV-Coreless-JST-1-25-Connector/dp/B07CFQMF1M?rnid=2470954011&rps=1 | n/a | - 15000KV brushed DC motor for vacuum fan - 2p 1.25mm pitch picoblade connector
 | Digikey | WM1731-ND | CONN HEADER VERT 2POS 1.25MM | 1 | $0.23 | 1 | $0.23 | https://www.digikey.com/en/products/detail/molex/0530470210/242853?s=N4IgTCBcDaIKwGYAMAWA7EsBGJIC6AvkA | - https://app.ultralibrarian.com/details/56453440-d29f-11ea-b5d0-0aebb021a1ea/Molex-Connector-Corporation/530470210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 - https://www.molex.com/en-us/products/part-detail/530470210 | - motor to board connector for vacuum fan - 2p 1.25mm pitch picoblade connector
 | Digikey | 1727-7806-1-ND | DIODE SCHOTTKY 60V 3A SOD123W | 1 | $0.39 | 1 | $0.78 | https://www.digikey.com/en/products/detail/nexperia-usa-inc/PMEG60T30ELRX/9086223 | https://app.ultralibrarian.com/details/785255d6-6dbf-11ee-9288-0ae0a3b49db5/Nexperia/PMEG60T30ELRX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 | - Flyback diodes for EMF protection
Ball Caster, nuts, screws | Amazon | B0BTYDZVM8 | 1 Oz (23 Grams) 3000-CPS Super Glue All Purpose with Anti Clog Cap. Ca Glue - Adhesive SuperGlue. Cyanoacrylate Glue for Hard Plastics, DIY Craft, Metal and Many More | 1 | $6.99 | 1 | $6.99 | https://www.amazon.com/gp/product/B0BTYDZVM8/ref=sw_img_1?smid=A3O523LQQ2NT7Z&th=1 |  | - superglue to attach 3D printed mounts to PCB
IR Sensing | Digikey | 1855-1027-ND | SENSOR OPTICAL 2-15CM ANALOG | 1 | $8.45 | 4 | $33.80 | https://www.digikey.com/en/products/detail/sharp-socle-technology/GP2Y0A51SK0F/4103863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 | https://www.mouser.com/ProductDetail/Sharp-Microelectronics/GP2Y0A51SK0F?qs=Qrpqs4v%252BmsahSKJyPt06pw%3D%3D | - Sharp IR distance sensor 2-15cm - shortest range sharp IR sensor available - connects w/ 3 position ZH JST connector - needs 10uF cap
 | Amazon | B09NC8Y2PK | CQRobot 100 Sets/500 Pieces 1.5 mm Pitch JST ZH 3-Pin IC Sockets & Plugs Adapter Connector Male and Female Terminal, Crimp DIP Kit. for Industrial Integrated Circuit JST Connector Cable. | 50 | $11.99 | 1 | $11.99 | https://www.amazon.com/CQRobot-Connector-Terminal-Industrial-Integrated/dp/B09NC8Y2PK | https://www.jst-mfg.com/product/index.php?series=290 | - JST ZH 1.5 pitch 3 position pack both male and female TH - 50 male, 50 female
 | Digikey | 490-GRM155R61A106ME11DCT-ND | CAP CER 10UF 10V X5R 0402 | 1 | $0.13 | 4 | $0.52 | https://www.digikey.com/en/products/detail/murata-electronics/GRM155R61A106ME11D/12091056 | n/a | - 10uF ceramic capacitor, SMD 0402 - needed for Sharp IR sensors
 | Digikey | CAY16-1001F4LFCT-ND | RES ARRAY 4 RES 1K OHM 1206 | 1 | $0.10 | 1 | $0.10 | https://www.digikey.com/en/products/detail/bourns-inc/CAY16-1001F4LF/2566504 | https://app.ultralibrarian.com/details/ccdadb33-1071-11e9-ab3a-0a3560a4cccc/Bourns-Electronics/CAY16-1001F4LF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 | - R1 resistor array to drop 2.5V max from IR sensor output to 1.8V - 1k Ohm resistor array, 4 resistors
 | Digikey | CAY16-2201F4LFCT-ND | RES ARRAY 4 RES 2.2K OHM 1206 | 1 | $0.10 | 1 | $0.10 | https://www.digikey.com/en/products/detail/bourns-inc/CAY16-2201F4LF/2566534 | https://app.ultralibrarian.com/details/1c159e3e-f9f4-11ed-b159-0a34d6323d74/Bourns-Electronics/CAY16-2201F4LF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 | - R2 resistor to drop 2.5V max from IR sensor output to 1.8V - 2.2k Ohms calculated w/ voltage divider equation - resistor array, 4 resistors
MCU | Digikey | 1175-1733-ND | CONN HEADER VERT 10POS 1.27MM | 1 | $0.68 | 1 | $0.68 | https://www.digikey.com/en/products/detail/cnc-tech/3221-10-0100-00/4878932 | https://www.arrow.com/en/products/3221-10-0100-00/cnc-tech-llc | - 2x5 TH JTAG programming header - small 1.27 pitch w/ key slot and shroud
 | Digikey | 2151-RT3215-32.768-12.5-TR-10PPMCT-ND | CRYSTAL 32.7680KHZ 12.5PF SMD | 1 | $0.42 | 1 | $0.42 | https://www.digikey.com/en/products/detail/raltron-electronics/RT3215-32-768-12-5-TR-10PPM/13151073 | https://app.ultralibrarian.com/details/ce5d9187-838b-11ec-9033-0a34d6323d74/Raltron/RT3215-32-768-12-5-TR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 | - 32.768kHz external crystal
 | Digikey | GJM1555C1H120FB01D | CAP CER 12PF 50V C0G/NP0 0402 | 1 | $0.16 | 2 | $0.32 | https://www.digikey.com/en/products/detail/murata-electronics/GJM1555C1H120FB01D/2592850 | https://app.ultralibrarian.com/details/d28e9410-f5b2-11eb-9033-0a34d6323d74/Murata/GQM1555C2D3R5CB01J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 | - 12pF caps for external crystal - needed on each crystal terminal - 0402 package | new
 | Amazon | B07BJJC3R6 | NOYITO TTL to RS232 Module TTL RS232 Male Female Mutual Conversion Module Serial Level Conversion to SP232 TTL Serial Port Communicates with RS232 Level Device 15KV ESD Protect (Female) | 1 | $7.99 | 1 | $7.99 | https://www.amazon.com/NOYITO-Module-Conversion-Arduino-communicates/dp/B07BJJC3R6?rnid=2470954011&rps=1 | not needed | - TTL to DB-9 (DE-9) translator for serial out
 | Amazon | B0759HSLP1 | OIKWAN USB to RS232, USB Serial Adapter with FTDI Chipset,USB 2.0 to Male DB9 Serial Cable for Windows 11,10, 8, 7, Vista, XP, 2000, Linux and Mac OS(6ft)… | 1 | $11.99 | 1 | $11.99 | https://www.amazon.com/Adapter-Chipset%EF%BC%8CDB9-Serial-Converter-Windows/dp/B0759HSLP1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 | not needed | - DB-9 (DE-9) to USB A for serial out
 | Digikey | AT32UC3L0256-AUT-ND | IC MCU 32BIT 256KB FLASH 48TQFP | 1 | $10.19 | 1 | $10.19 | https://www.digikey.com/en/products/detail/microchip-technology/AT32UC3L0256-AUT/3046397 | https://app.ultralibrarian.com/details/89115949-109b-11e9-ab3a-0a3560a4cccc/Microchip/AT32UC3L0256-AUT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 | - AT32UC3L0256 AVR MCU to replace Arduino - 50MHz, faster than controller above, operates on 3.3V - 12b ADC, PWM, programmed via JTAG and aWire - schematic checklist: HERE
 | Digikey | 490-GRM155R61A106ME11DCT-ND | CAP CER 10UF 10V X5R 0402 | 1 | $0.13 | 1 | $0.13 | https://www.digikey.com/en/products/detail/murata-electronics/GRM155R61A106ME11D/12091056 | n/a | - 10uF capacitor for AT32UC3L0256 VDDin - page 4 of schematic checklist - small 0402 package
 | Digikey | 445-4952-1-ND | CAP CER 0.1UF 16V X7R 0402 | 1 | $0.10 | 3 | $0.30 | https://www.digikey.com/en/products/detail/tdk-corporation/C1005X7R1C104K050BC/2093220 | n/a | - 0.1uf ceramic cap for AT32UC3L0256 VDDin, VDDio, and VDDcore - page 4 of schematic checklist - 0402 package
 | Digikey | 445-9097-1-ND | CAP CER 2.2UF 10V X7S 0402 | 1 | $0.29 | 1 | $0.29 | https://www.digikey.com/en/products/detail/tdk-corporation/C1005X7S1A225K050BC/3661557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 | n/a | - 2.2uF ceramic cap for AT32UC3L0256 VDDio, and VDDcore - page 4 of schematic checklist - 0402 package
 | Digikey | 445-4952-1-ND | CAP CER 0.1UF 16V X7R 0402 | 1 | $0.10 | 2 | $0.10 | https://www.digikey.com/en/products/detail/tdk-corporation/C1005X7R1C104K050BC/2093220 | n/a | - 0.1uF ceramic cap for AT32UC3L0256 VDDana and ADVREF - page 5 of schematic checklist - 0402 package
 | Digikey | 732-74269241152CT-ND | WE-TMSB SMT EMI SUPPRESSION FERR | 1 | $0.13 | 1 | $0.13 | https://www.digikey.com/en/products/detail/w%C3%BCrth-elektronik/74269241152/17830009 | https://app.ultralibrarian.com/details/ab67cd4b-c364-11ed-b159-0a34d6323d74/Wurth-Electronics/74269244182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 | - ferrite bead for for AT32UC3L0256 VDDana and ADVREF - page 5 of schematic checklist, and page 15 on xplained dev board schematic: HERE - 0402 package
 | Digikey | 445-4952-1-ND | CAP CER 0.1UF 16V X7R 0402 | 1 | $0.10 | 1 | $0.10 | https://www.digikey.com/en/products/detail/tdk-corporation/C1005X7R1C104K050BC/2093220 | n/a | - 0.1uF ceramic cap for JTAG on AT32UC3L0256 - 0402 package
 | Digikey | 541-10.0KLCT-ND | RES SMD 10K OHM 1% 1/16W 0402 | 1 | $0.10 | 1 | $0.10 | https://www.digikey.com/en/products/detail/vishay-dale/CRCW040210K0FKED/1178121 | n/a | - 10k resistor for pulling down enable signal - 0402 package
Bluetooth | Sparkfun | SKU: WRL-23287 | SparkFun BlueSMiRF v2 - Headers | 1 | $11.95 | 1 | $11.95 | https://www.sparkfun.com/sparkfun-bluesmirf-v2-headers.html | n/a | - ESP32 bluetooth module from sparkfun to serve as a UART bridge - works out of the box- all we need are 2.54mm pitch pins and a 5V supply
Misc | Digikey | 2449-CS1213AGF160CT-ND | SWITCH TACTILE SPST-NO 0.05A 50V | 1 | $0.40 | 1 | $0.40 | https://www.digikey.com/en/products/detail/cit-relay-and-switch/CS1213AGF160/16607723 | https://app.ultralibrarian.com/details/600608b2-d687-11ed-b159-0a34d6323d74/CIT-Relay-Switch/CS1213AGF260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 | - 3.9mm x 2.9mm smd pushbutton for config - 2mm high
 | Digikey | RCS0402100KFKED | RES 100K OHM 1% 1/3W 0402 | 1 | $0.12 | 4 | $0.48 | https://www.digikey.com/en/products/detail/vishay-dale/RCS0402100KFKED/5867045 | n/a | - 100k 0402 resistor for pushbutton debouncing | new (dupe)
 | Digikey | GRM155R60J474KE19D | GRM155R60J474KE19D | 1 | $0.10 | 1 | $0.10 | https://www.digikey.com/en/products/detail/murata-electronics/GRM155R60J474KE19D/702530 | n/a | - 0.47uF 0402 cap for pushbutton debouncing | new
 | DIgikey | 1N4148W-7-F | DIODE STANDARD 100V 150MA SOD123 | 1 | $0.17 | 1 | $0.17 | https://www.digikey.com/en/products/detail/diodes-incorporated/1N4148W-7-F/814371 | https://app.ultralibrarian.com/details/1598d007-1067-11e9-ab3a-0a3560a4cccc/Diodes-Inc/1N4148W-7-F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 | - small diode for pushbutton debouncing | new
 | Digikey | 754-1105-1-ND | LED YELLOW CLEAR CHIP SMD | 1 | $0.41 | 2 | $0.82 | https://www.digikey.com/en/products/detail/kingbright/APHHS1005SYCK/1747503 | https://app.ultralibrarian.com/details/f21eebf1-5907-11ee-9288-0ae0a3b49db5/Kingbright/APHHS1005CGCK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 | - yellow SMD LED 0402 package for debug, and battery comparator warning indication
 | Digikey | 754-2123-1-ND | LED RED CLEAR 2SMD | 1 | $0.52 | 2 | $1.04 | https://www.digikey.com/en/products/detail/kingbright/APHHS1005LSECK-J3-PF/7318976 | https://app.ultralibrarian.com/details/f21eebf1-5907-11ee-9288-0ae0a3b49db5/Kingbright/APHHS1005CGCK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 | - red SMD LED 0402 package for debug, and battery comparator failure indication
 | Digikey | 754-1503-1-ND | LED GREEN CLEAR CHIP SMD | 1 | $0.70 | 1 | $0.70 | https://www.digikey.com/en/products/detail/kingbright/APHHS1005ZGC/2263569 | https://app.ultralibrarian.com/details/f21eebf1-5907-11ee-9288-0ae0a3b49db5/Kingbright/APHHS1005CGCK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 | - green SMD LED 0402 package for debug
 | Digikey | 754-1504-1-ND | LED BLUE CLEAR CHIP SMD | 1 | $0.51 | 1 | $0.51 | https://www.digikey.com/en/products/detail/kingbright/APHHS1005QBC-D/2263568 | https://app.ultralibrarian.com/details/f21eebf1-5907-11ee-9288-0ae0a3b49db5/Kingbright/APHHS1005CGCK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 | - blue SMD LED 0402 package for debug
 | Digikey | CAY16-2201F4LFCT-ND | RES ARRAY 4 RES 2.2K OHM 1206 | 1 | $0.10 | 1 | $0.10 | https://www.digikey.com/en/products/detail/bourns-inc/CAY16-2201F4LF/2566534 | https://app.ultralibrarian.com/details/1c159e3e-f9f4-11ed-b159-0a34d6323d74/Bourns-Electronics/CAY16-2201F4LF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 | - 2.2k Ohm resistor array, 4 resistors
 | Digikey | 952-2664-1-ND | PC TEST POINT NATURAL | 1 | $0.31 |  | $0.00 | https://www.digikey.com/en/products/detail/harwin-inc/S2751-46R/5250499 | https://www.mouser.com/ProductDetail/Harwin/S2751-46R?qs=DaxoyN%2FvrebM3VuuS3MPNA%3D%3D | - TH testpoint to probe mouse
PCB | JLC PCB | n/a | PCB prototype:Y4-5162408A | 5 | $2.00 | 1 | $2.00 | https://jlcpcb.com/?_ga=2.135028465.1970803033.1675648070-692031392.1675094888 |  | - solid and cheap PCB vendor - no issues so far, purple nice and deep purple
 |  |  |  |  |  | total cost: | #REF!
 |  |  |  |  |  | 116
 | resistors: | https://www.digikey.com/en/products/filter/chip-resistor-surface-mount/52
 | headers: | https://www.digikey.com/en/products/filter/rectangular-connectors/headers-receptacles-female-sockets/315
 | ceramic caps: | https://www.digikey.com/en/products/filter/ceramic-capacitors/60
 | electrolytic caps: | https://www.digikey.com/en/products/filter/aluminum-electrolytic-capacitors/58
 | motor drivers: | https://www.digikey.com/en/products/filter/motor-drivers-controllers/744
 | linear regulators: | https://www.digikey.com/en/products/filter/voltage-regulators-linear/699
 | to-220 heatsinks: | https://www.digikey.com/en/products/filter/thermal/heat-sinks/to-220/219
 | screws: | https://www.digikey.com/en/products/filter/screws-bolts/572
 | nuts: | https://www.digikey.com/en/products/filter/nuts/573
 | MCUs: | https://www.digikey.com/en/products/filter/microcontrollers/685
 | more MCUs: | https://www.digikey.com/en/products/filter/microcontrollers/685
 | IMUs: | https://www.digikey.com/en/products/filter/imus-inertial-measurement-units/567
 | rectifier diodes: | https://www.digikey.com/en/products/filter/single-diodes/280
 | inductors: | https://www.digikey.com/en/products/filter/fixed-inductors/71
 | switching regulators: | https://www.digikey.com/en/products/filter/voltage-regulators-dc-dc-switching-regulators/739
