Mouse-Unit-07/hardware-motherboard/design-explanation/_images/overview/motherboard-components.drawio.png

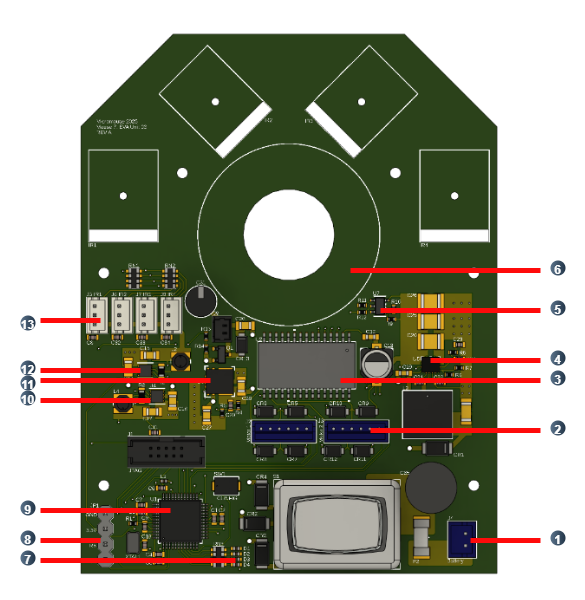
design-explanation/_images/overview/motherboard-components.drawio.png
