Mouse-Unit-07/hardware-motherboard/3d-mounts/wheel mount gears- small gear.3mf

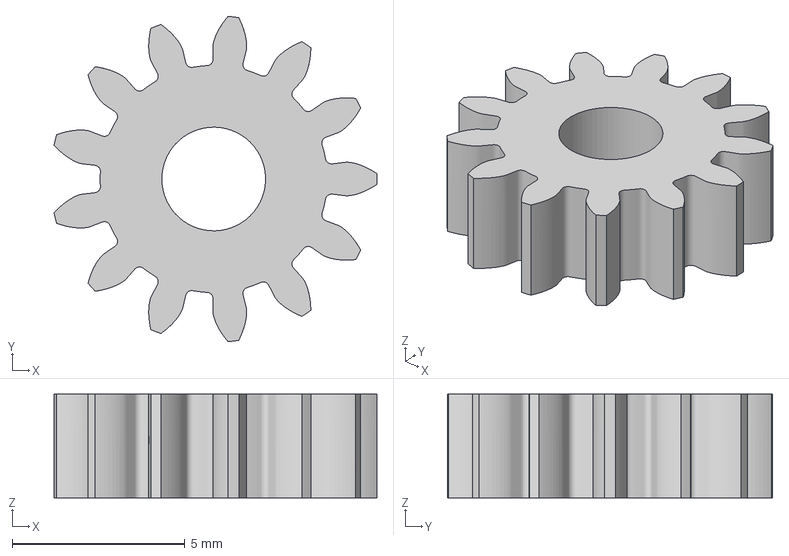
[picture p21: CAD file, 2025-04-27, last stored version]
3d-mounts/wheel mount gears- small gear.3mf
9.35 x 9.41 x 3.00 mm
