Mouse-Unit-07/hardware-motherboard/3d-mounts/wheel mount- left.3mf

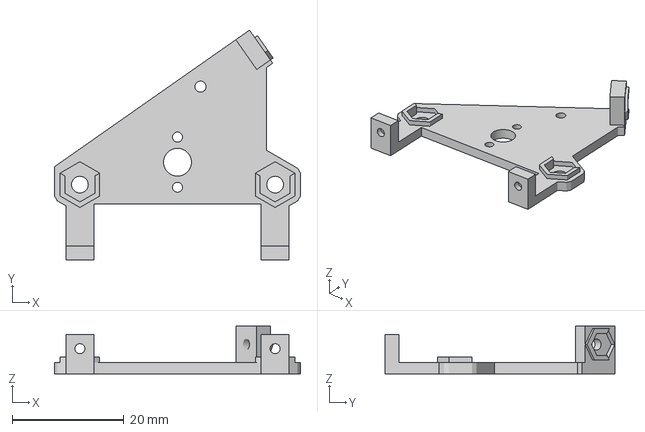
[picture p22: CAD file, 2025-04-27, last stored version]
3d-mounts/wheel mount- left.3mf
44.1 x 41.2 x 8.52 mm
