Mouse-Unit-07/hardware-motherboard/3d-mounts/Battery Mount- 450mAh LiPo.3mf

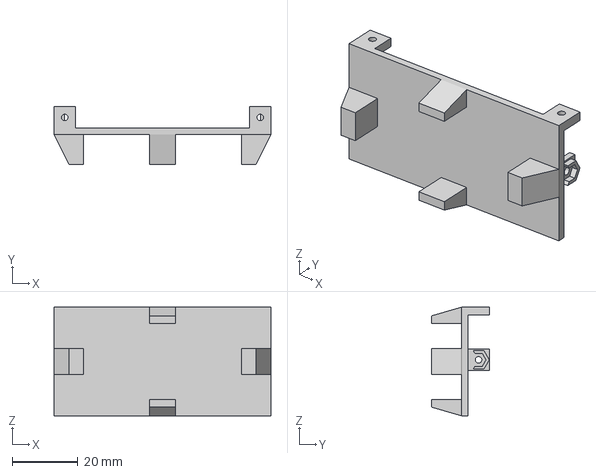
[picture p23: CAD file, 2025-04-27, last stored version]
3d-mounts/Battery Mount- 450mAh LiPo.3mf
66.0 x 17.5 x 33.0 mm
