Mouse-Unit-07/hardware-motherboard/3d-mounts/vacuum motor mount.3mf

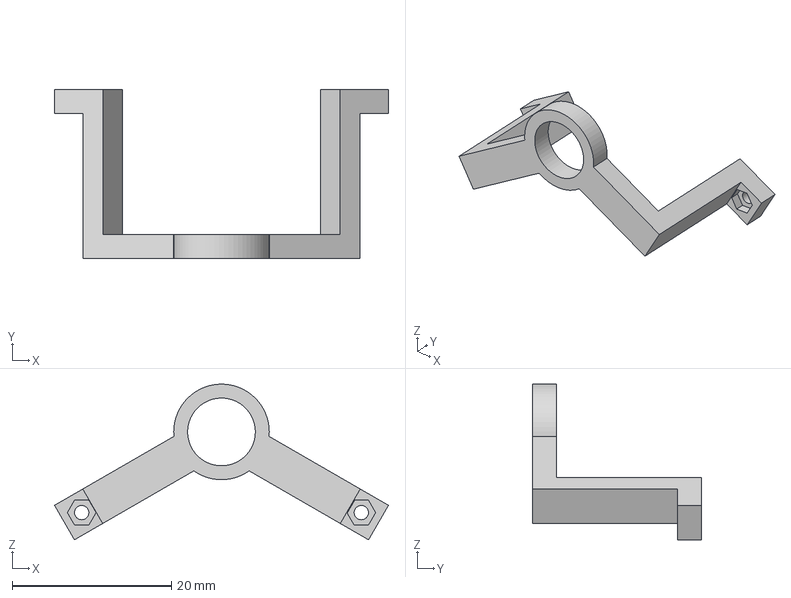
[picture p24: CAD file, 2025-04-27, last stored version]
3d-mounts/vacuum motor mount.3mf
41.9 x 21.2 x 19.5 mm
