Mouse-Unit-07/hardware-motherboard/3d-mounts/vacuum fan.3mf

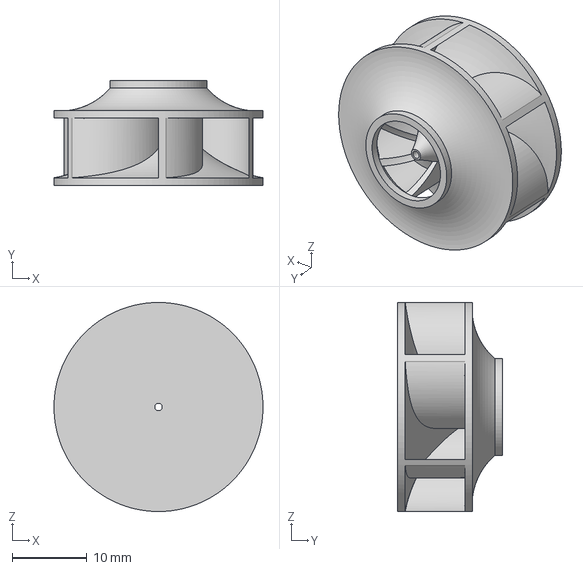
[picture p25: CAD file, 2025-04-27, last stored version]
3d-mounts/vacuum fan.3mf
28.0 x 14.0 x 28.0 mm
