Mouse-Unit-07/hardware-motherboard/3d-mounts/wheel mount gears- large gear.3mf

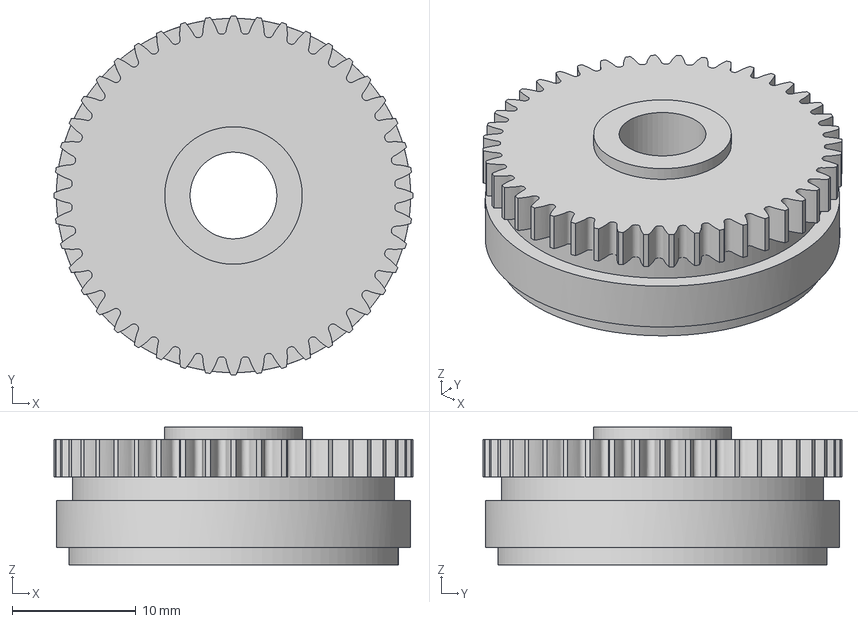
[picture p26: CAD file, 2025-04-27, last stored version]
3d-mounts/wheel mount gears- large gear.3mf
29.0 x 29.0 x 11.1 mm
