Mouse-Unit-07/hardware-motherboard/3d-mounts/sharp sensor mount.3mf

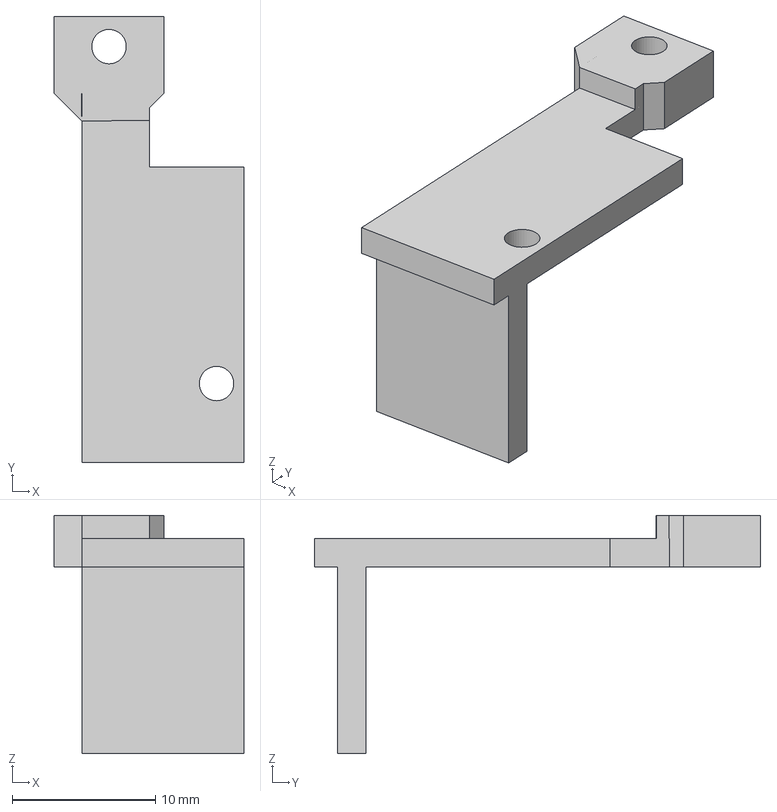
[picture p27: CAD file, 2025-04-27, last stored version]
3d-mounts/sharp sensor mount.3mf
13.2 x 31.1 x 16.6 mm
