Mouse-Unit-07/hardware-motherboard/(list of files, cad)

Other CAD files:
3d-mounts/wheel mount- right.3mf
