Mouse-Unit-07/hardware-motherboard/schematic/mouse-unit-07-schematic-B.pdf

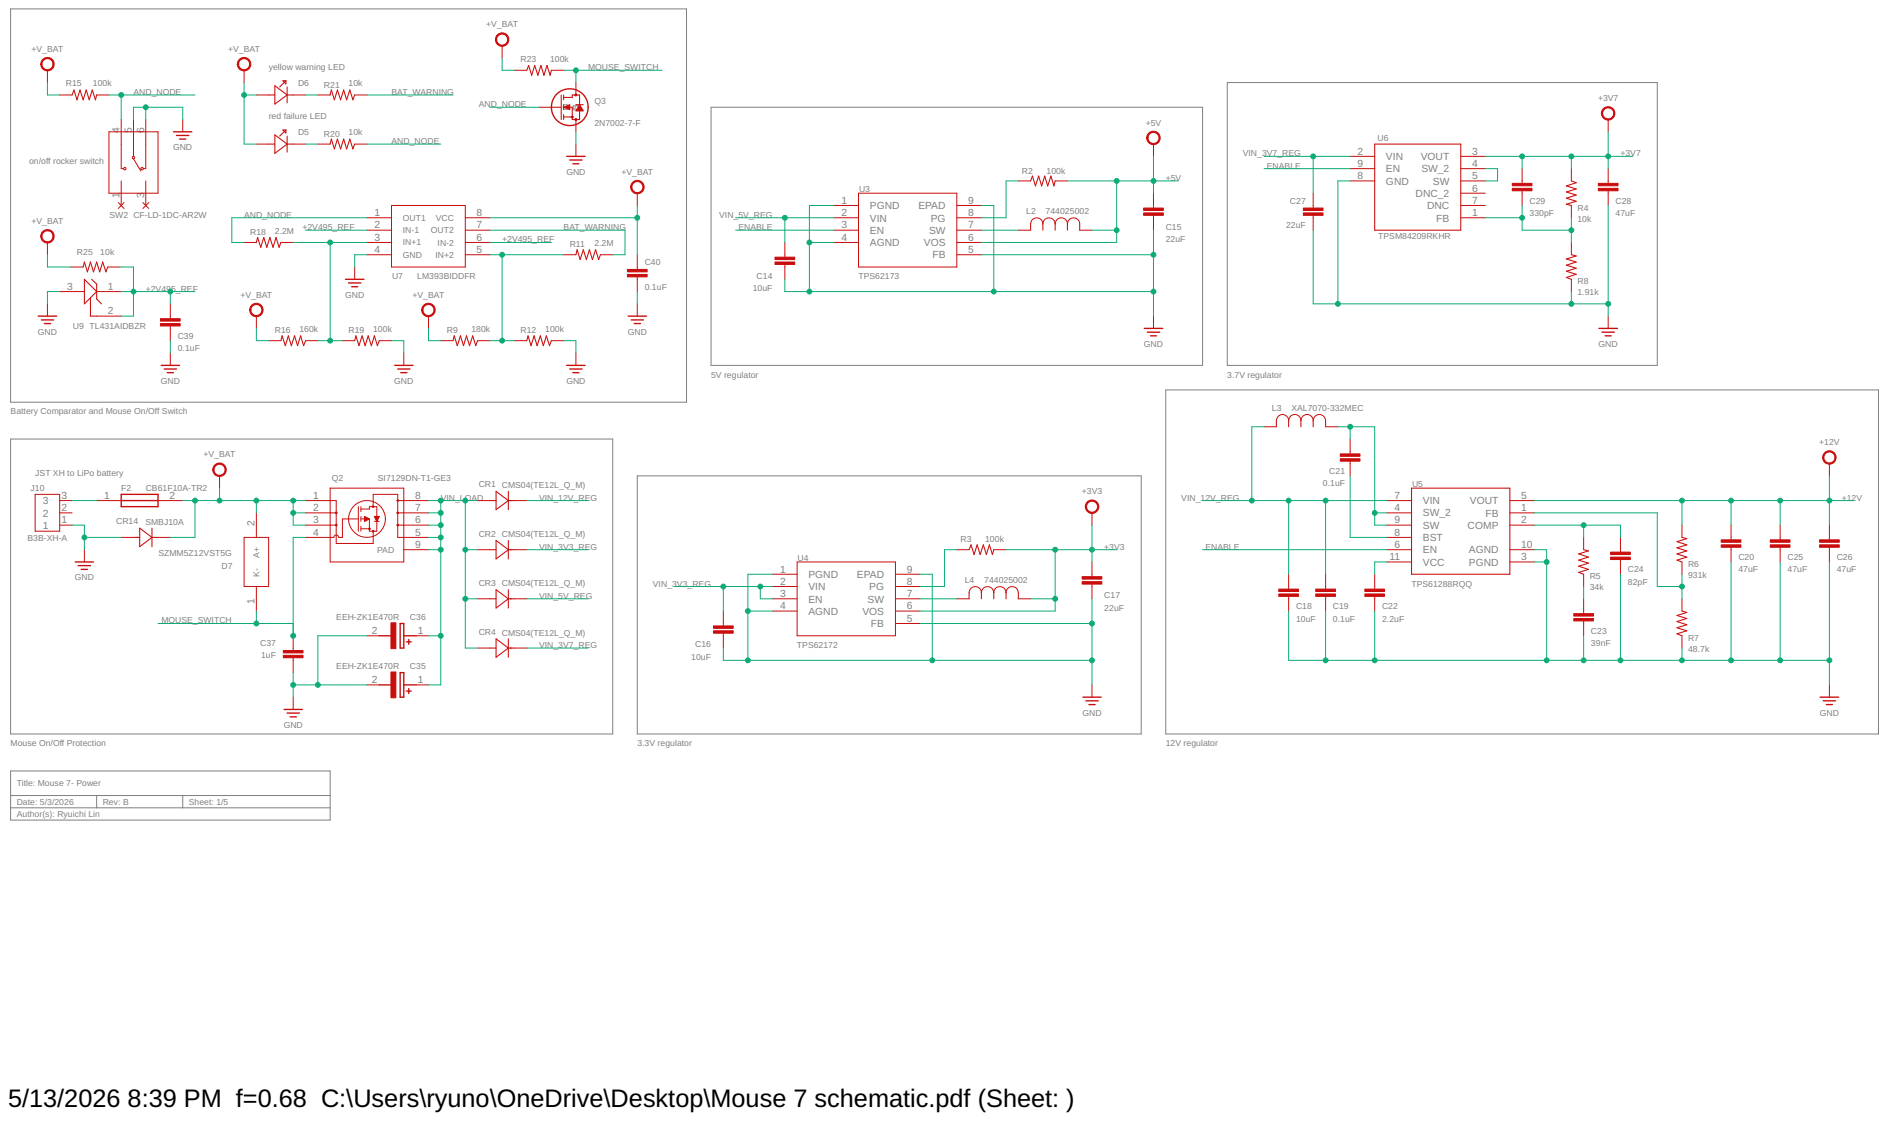
[picture p28: page 1]

on/off rocker switch

3.7V regulator Battery Comparator and Mouse On/Off Switch

5/13/2026 8:39 PM f=0.68 C:\Users\ryuno\OneDrive\Desktop\Mouse 7 schematic.pdf (Sheet: )

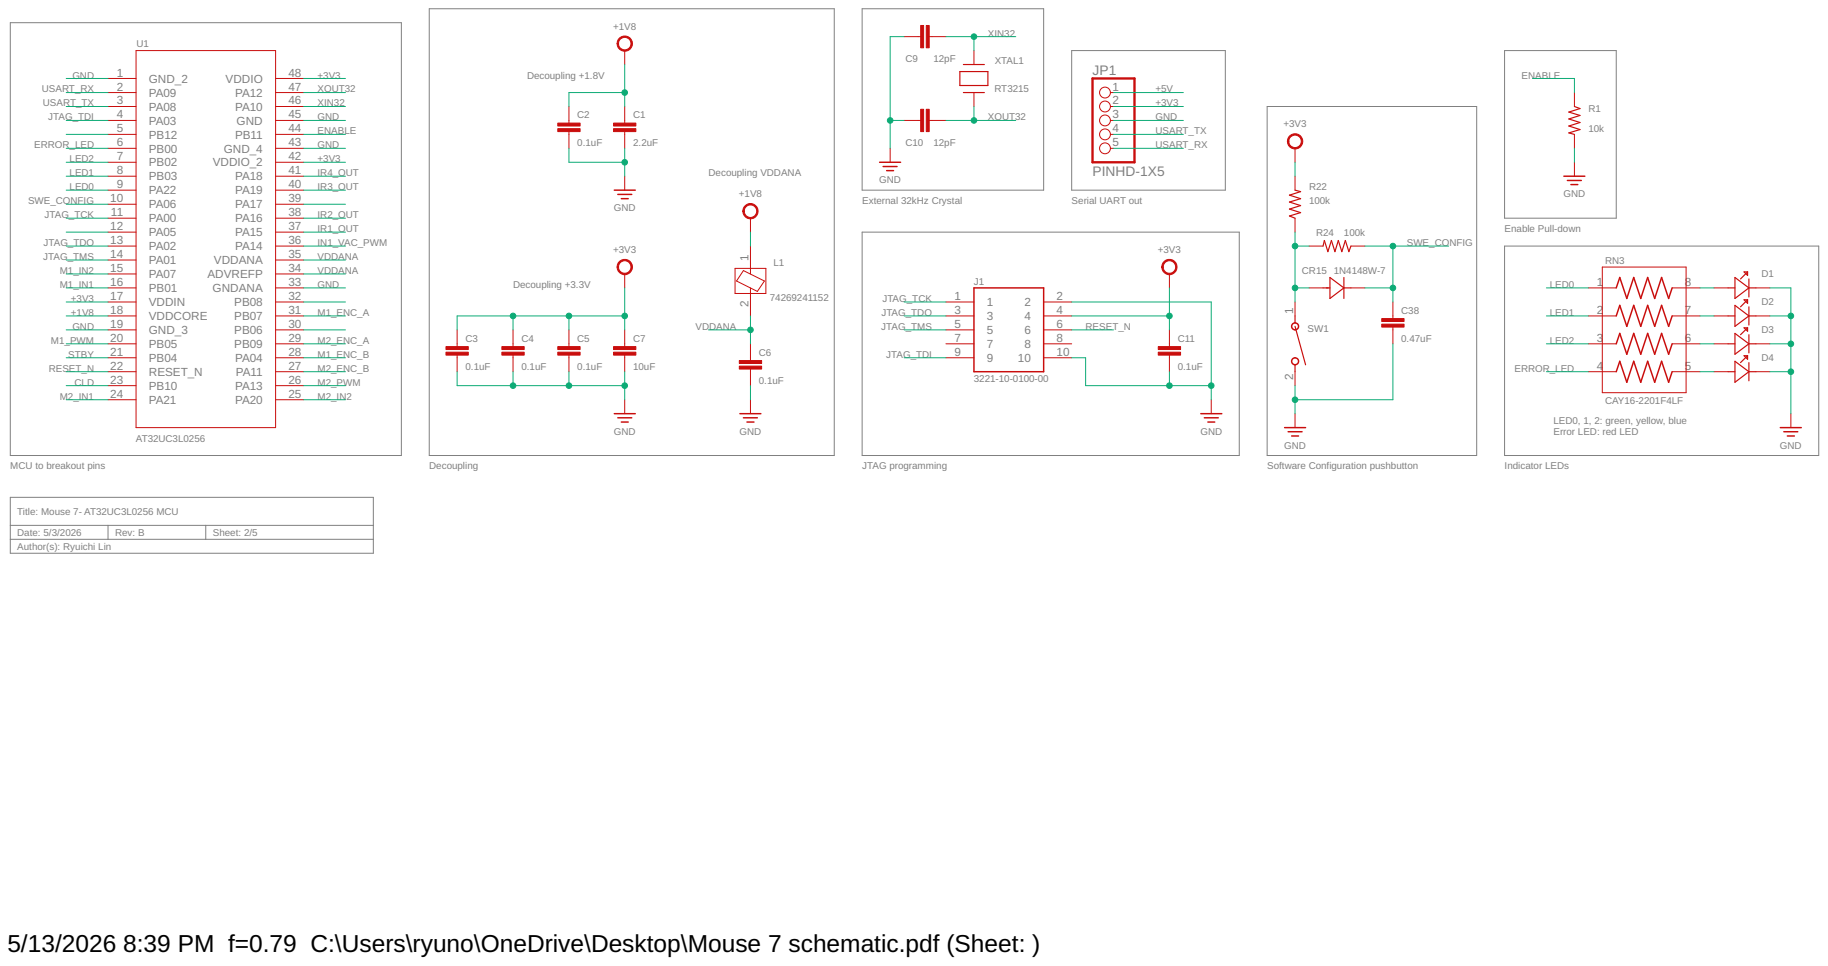
[picture p29: page 2]

MCU to breakout pins

Sheet: 2/5 Author(s): Ryuichi Lin

5/13/2026 8:39 PM f=0.79 C:\Users\ryuno\OneDrive\Desktop\Mouse 7 schematic.pdf (Sheet: )

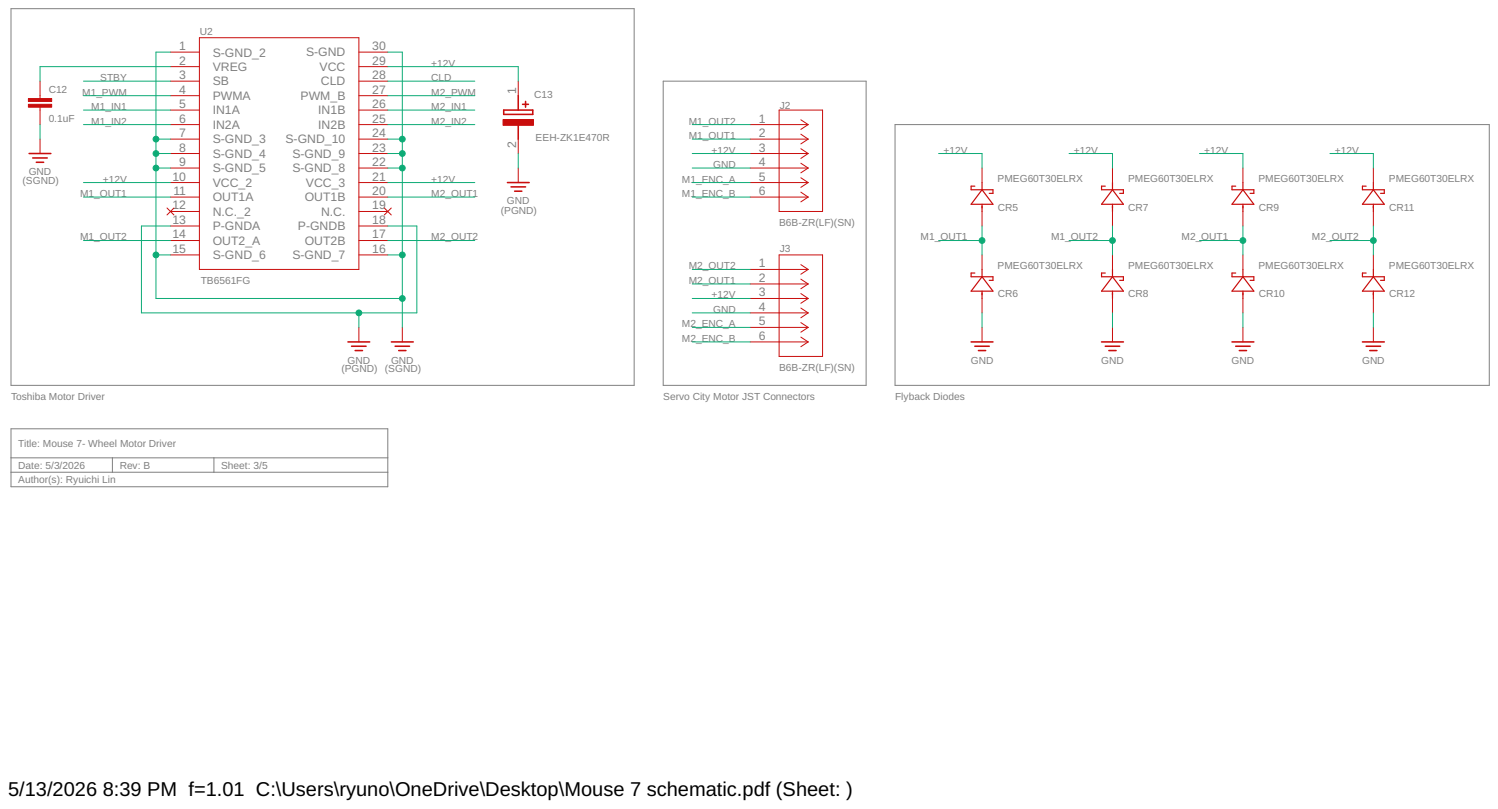
[picture p30: page 3]

5/13/2026 8:39 PM f=1.01 C:\Users\ryuno\OneDrive\Desktop\Mouse 7 schematic.pdf (Sheet: )

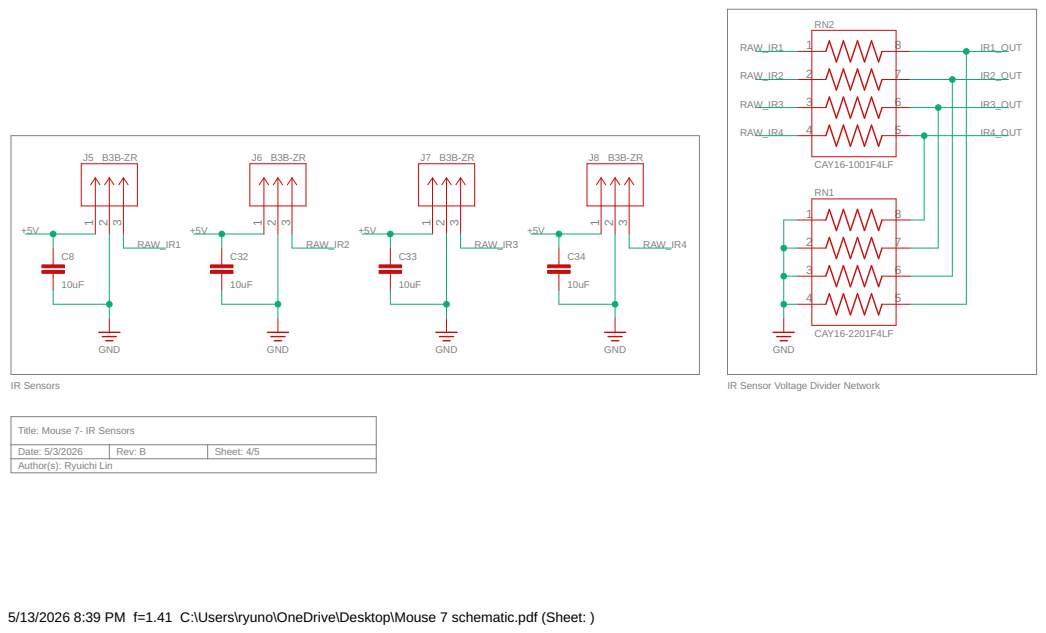
[picture p31: page 4]

5/13/2026 8:39 PM f=1.41 C:\Users\ryuno\OneDrive\Desktop\Mouse 7 schematic.pdf (Sheet: )

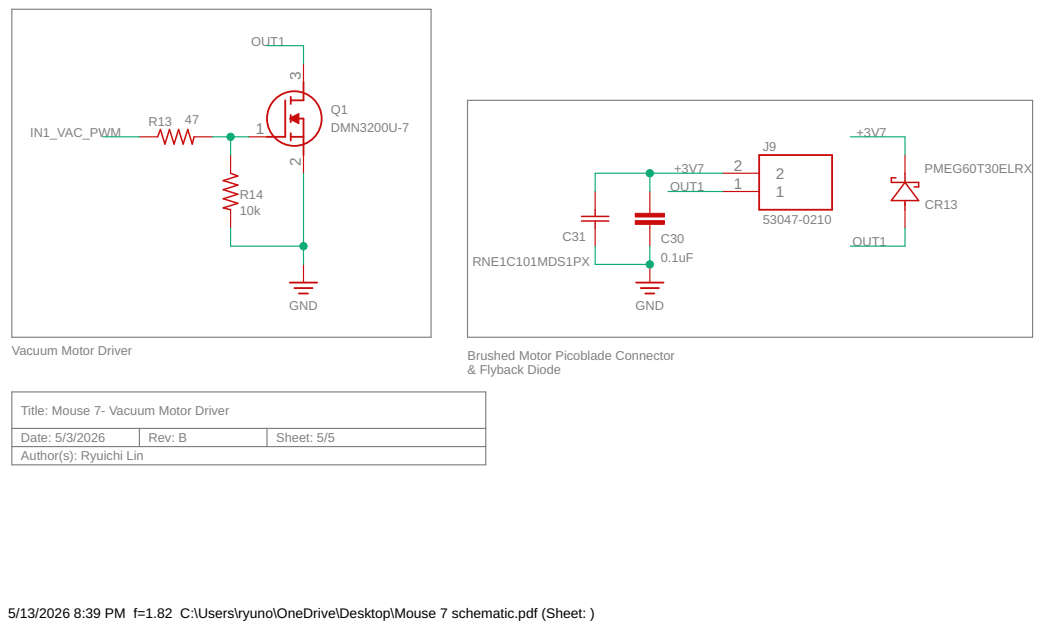
[picture p32: page 5]

Title: Mouse 7- Vacuum Motor Driver
Author(s): Ryuichi Lin

5/13/2026 8:39 PM f=1.82 C:\Users\ryuno\OneDrive\Desktop\Mouse 7 schematic.pdf (Sheet: )
