Mouse-Unit-07/hardware-motherboard/mechanical-drawings/mouse-unit-07-drawing-A.pdf

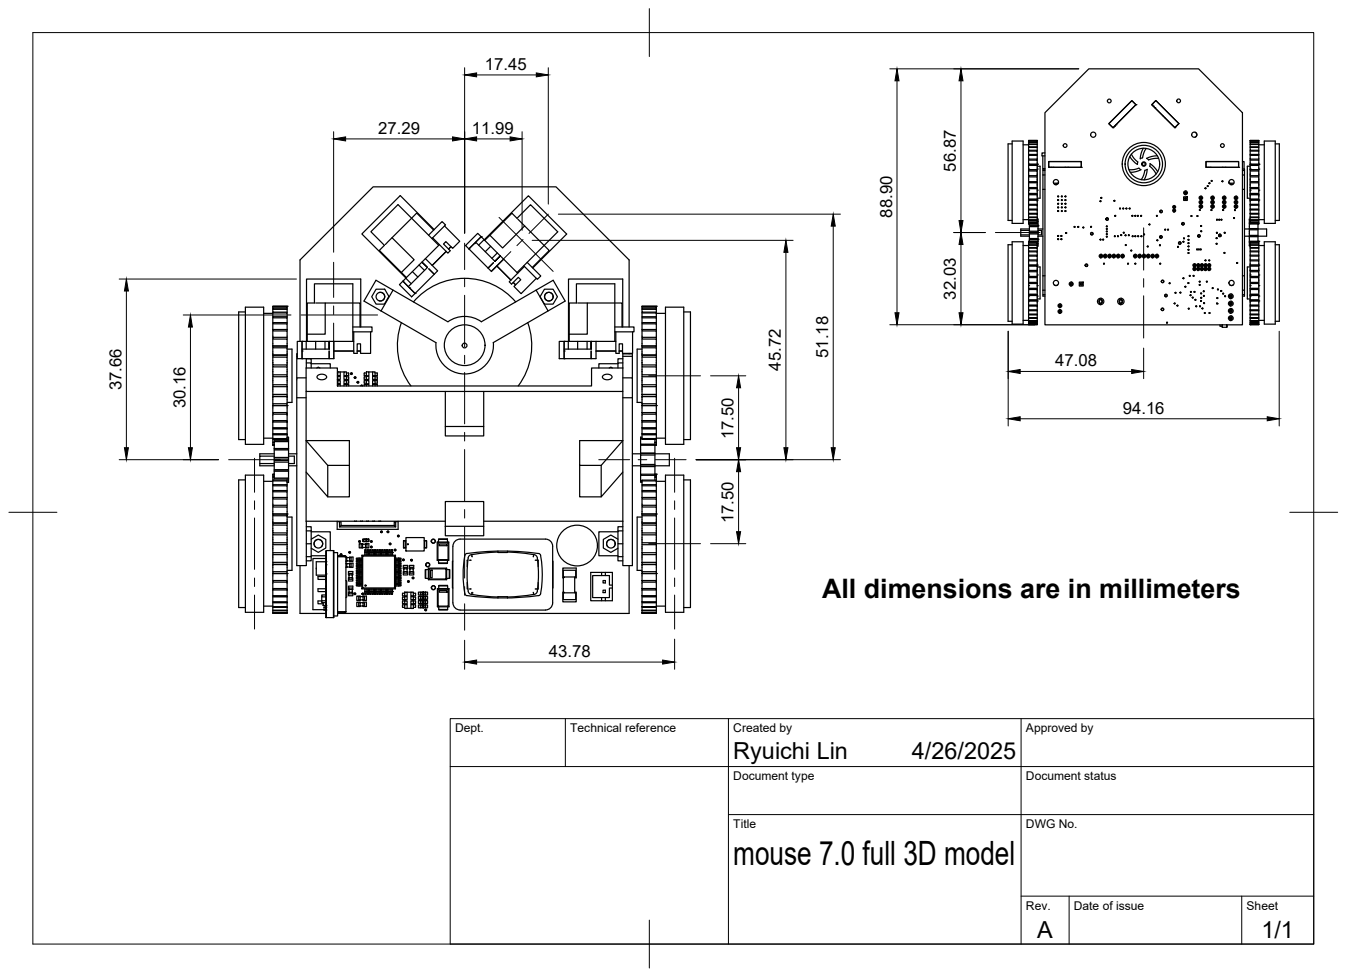
[picture p33: page 1]
Dept.; Technical reference; Created by; Approved by; Document type; Document status; Title; DWG No.; Rev.; Date of issue; Sheet; Ryuichi Lin

All dimensions are in millimeters

mouse 7.0 full 3D model
