Mouse-Unit-07/hardware-motherboard/schematic/mouse-unit-07-schematic-A.pdf

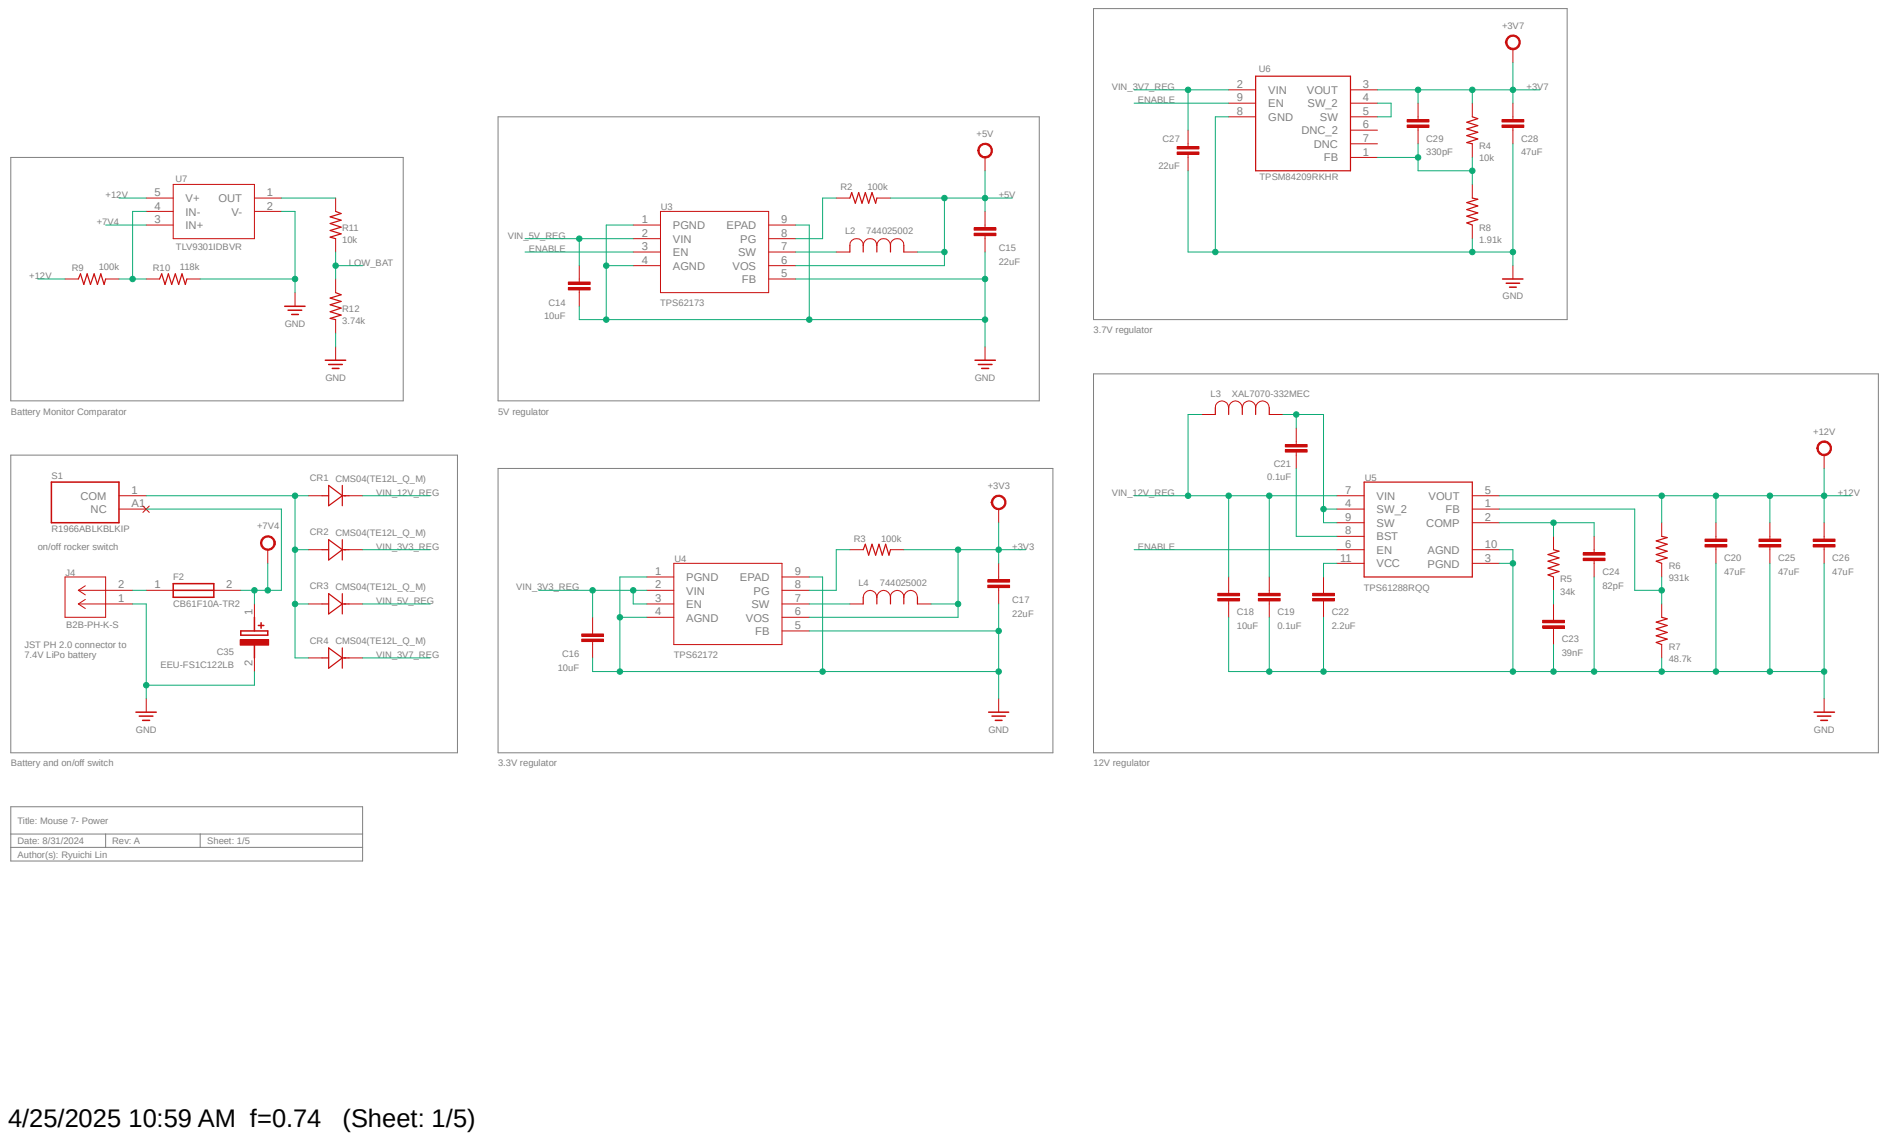
[picture p34: page 1]

3.7V regulator Battery Monitor Comparator B2B-PH-K-S

on/off rocker switch

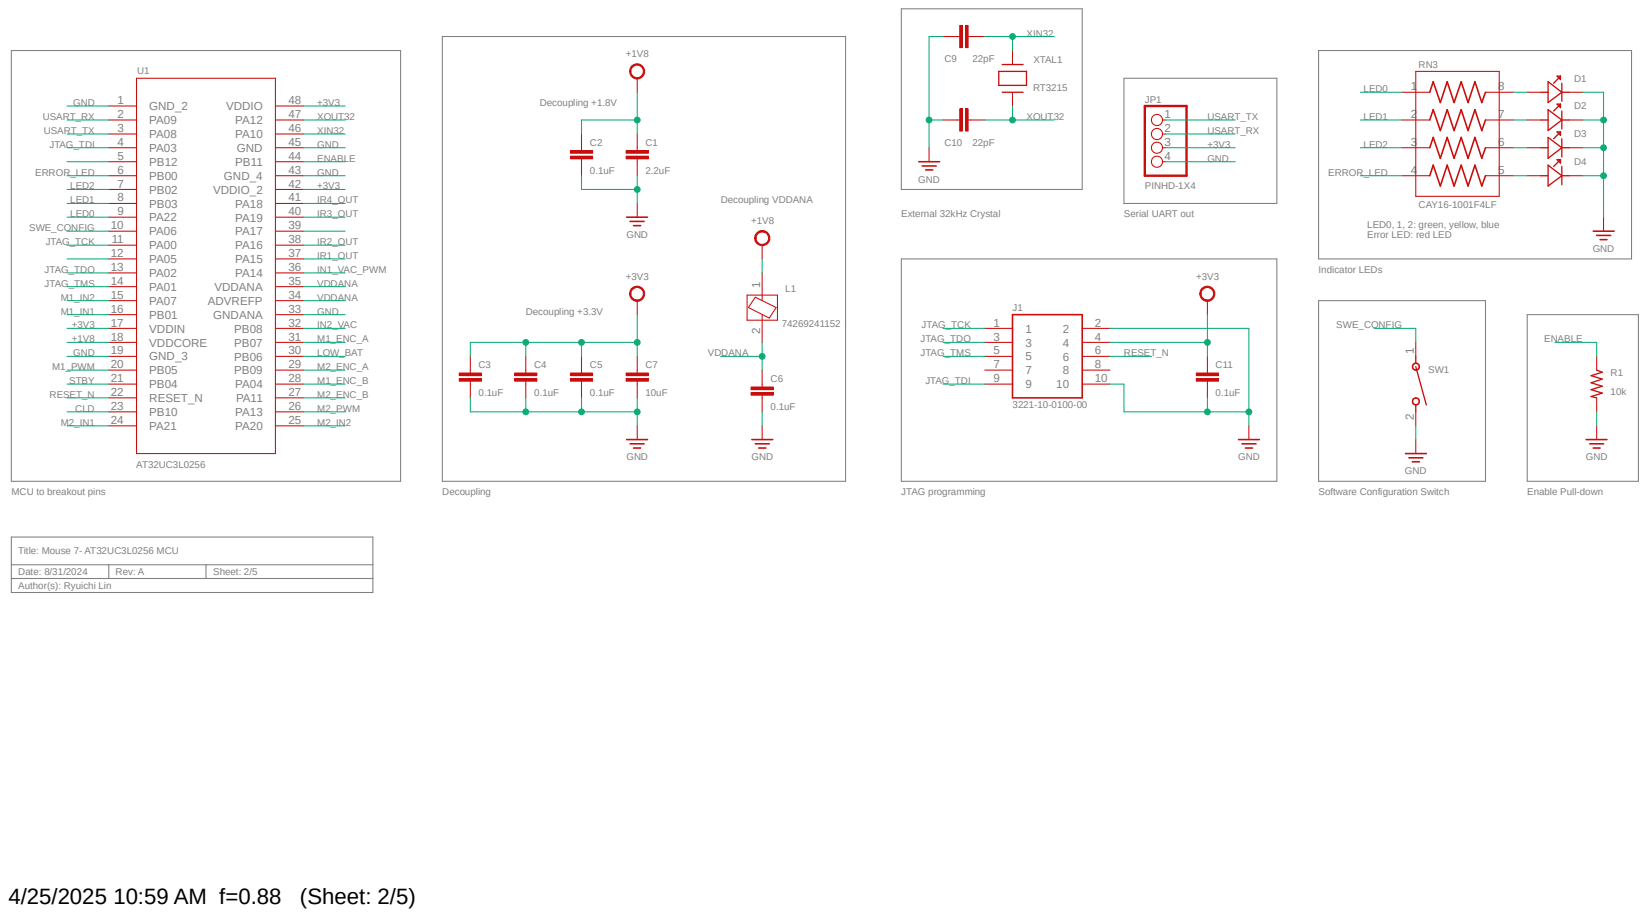
[picture p35: page 2]

Indicator LEDs LED0, 1, 2: green, yellow, blue Error LED: red LED

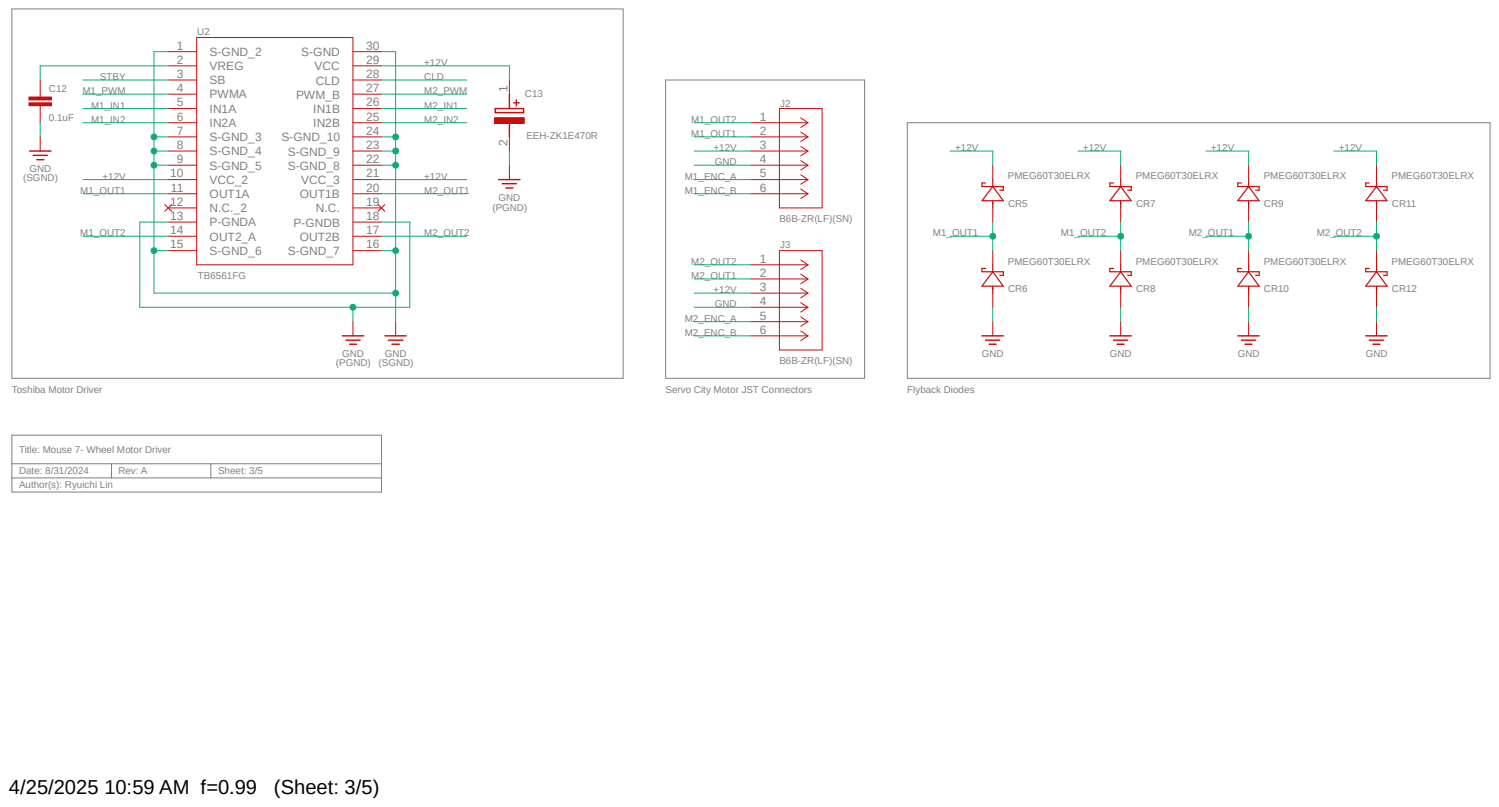
[picture p36: page 3]
4/25/2025 10:59 AM f=0.99 (Sheet: 3/5); (PGND); (SGND); (SGND) Toshiba Motor Driver; Servo City Motor JST Connectors Date: 8/31/2024; Rev: A; Title: Mouse 7- Wheel Motor Driver; Sheet: 3/5 Author(s): Ryuichi Lin; Flyback Diodes TB6561FG; GND GND; GND; PMEG60T30ELRX; PMEG60T30ELRX GND; EEH-ZK1E470R; U2S-GND_2 1; VREG 2; PWMA 4; S-GND_3 7; S-GND_4 8; S-GND_5 9; VCC_2 10; OUT1A 11; P-GNDA 13; OUT2_A 14; S-GND_6 15; S-GND_7; 16 OUT2B; 17 P-GNDB; 19 OUT1B; 20 VCC_3; 21 S-GND_8; 22 S-GND_9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

RN2
1

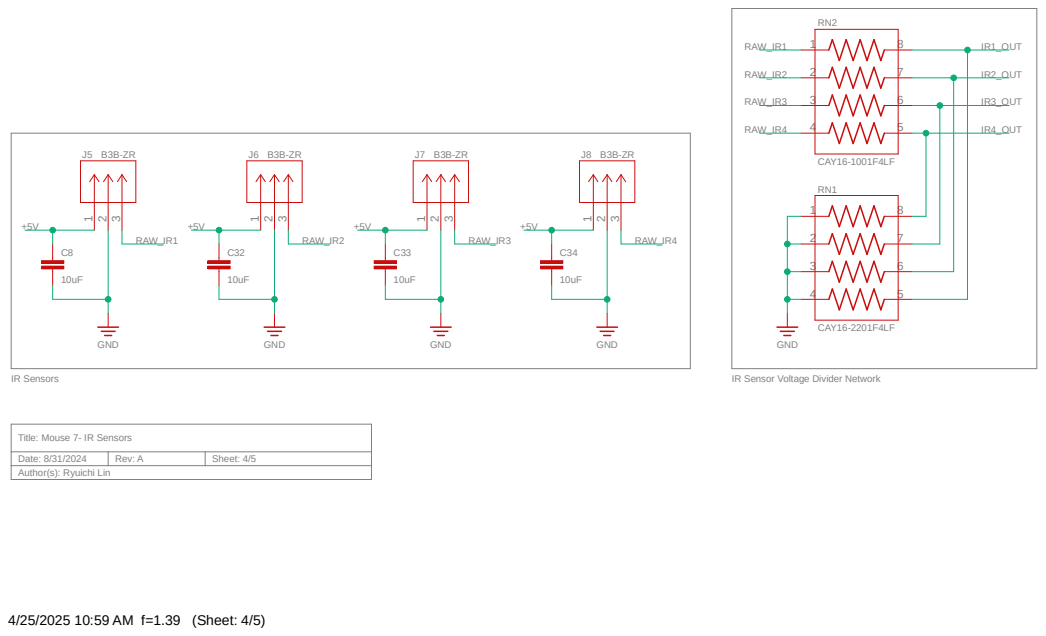
[picture p37: page 4]

Title: Mouse 7- IR Sensors
Author(s): Ryuichi Lin

# OUT1

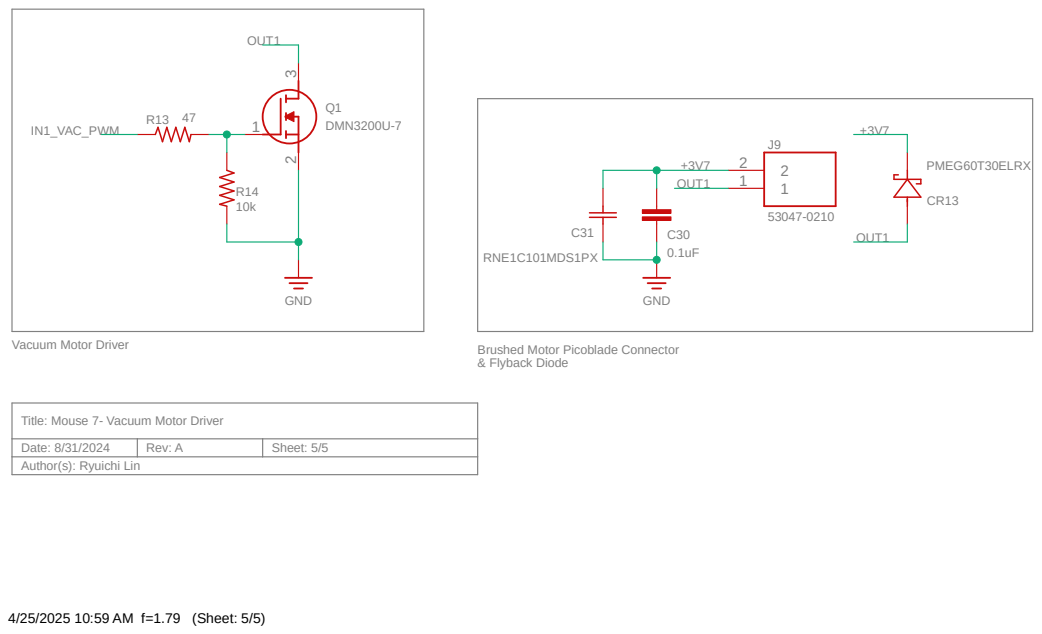
[picture p38: page 5]
4/25/2025 10:59 AM f=1.79 (Sheet: 5/5); Vacuum Motor Driver; Brushed Motor Picoblade Connector; & Flyback Diode; Date: 8/31/2024; Rev: A; Sheet: 5/5; 0.1uF RNE1C101MDS1PX; PMEG60T30ELRX; DMN3200U-7; GND; OUT1; IN1_VAC_PWM

Title: Mouse 7- Vacuum Motor Driver

Author(s): Ryuichi Lin
