Mouse-Unit-07/hardware-motherboard/design-explanation/power/ti-regulator-circuits/TI-webench-12v-circuit.pdf

## WEBENCH ® Design Report

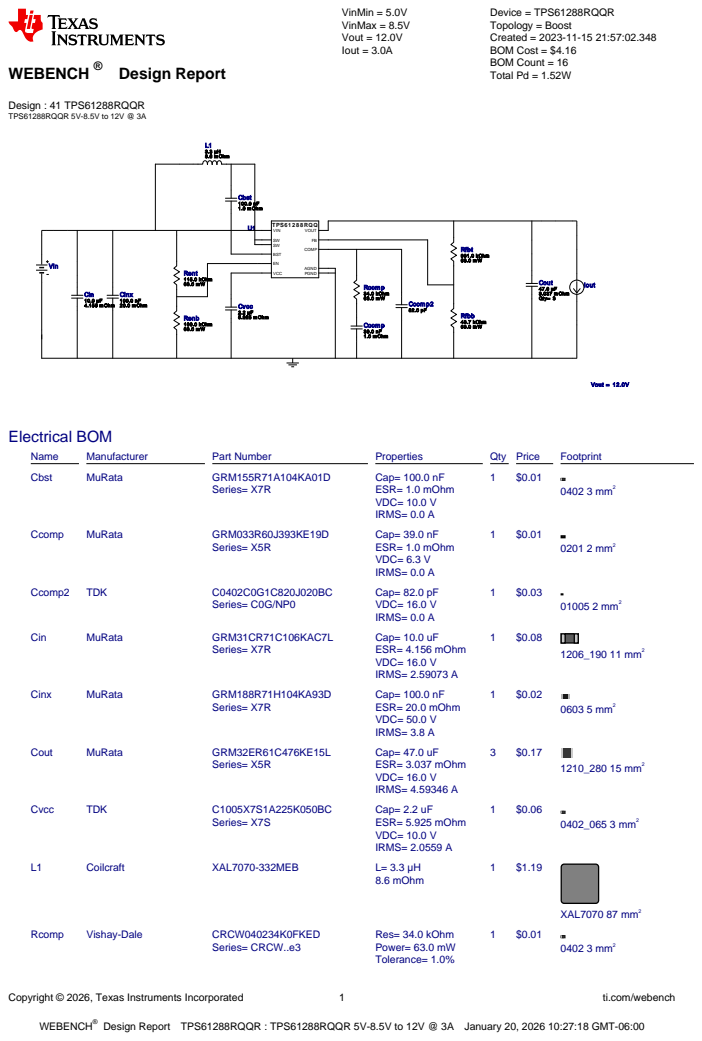
[picture p39: page 1]
Copyright © 2026, Texas Instruments Incorporated; ti.com/webench; WEBENCH®; Design : 41 TPS61288RQQR TPS61288RQQR 5V-8.5V to 12V @ 3A; VinMin = 5.0V VinMax = 8.5V Vout = 12.0V Iout = 3.0A; Device = TPS61288RQQR Topology = Boost Created = 2023-11-15 21:57:02.348 BOM Cost = $4.16 BOM Count = 16 Total Pd = 1.52W; Cin 10.0 µF 4.156 m Ohm; Cbst 100.0 nF 1.0 m Ohm; Rfbb 48.7 kOhm 63.0 m W; Ccom p2 82.0 pF; Rfbt 931.0 kOhm 63.0 m W; Ccom p 39.0 nF 1.0 m Ohm; Rent 115.0 kOhm 63.0 m W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

Design Report TPS61288RQQR : TPS61288RQQR 5V-8.5V to 12V @ 3A January 20, 2026 10:27:18 GMT-06:00

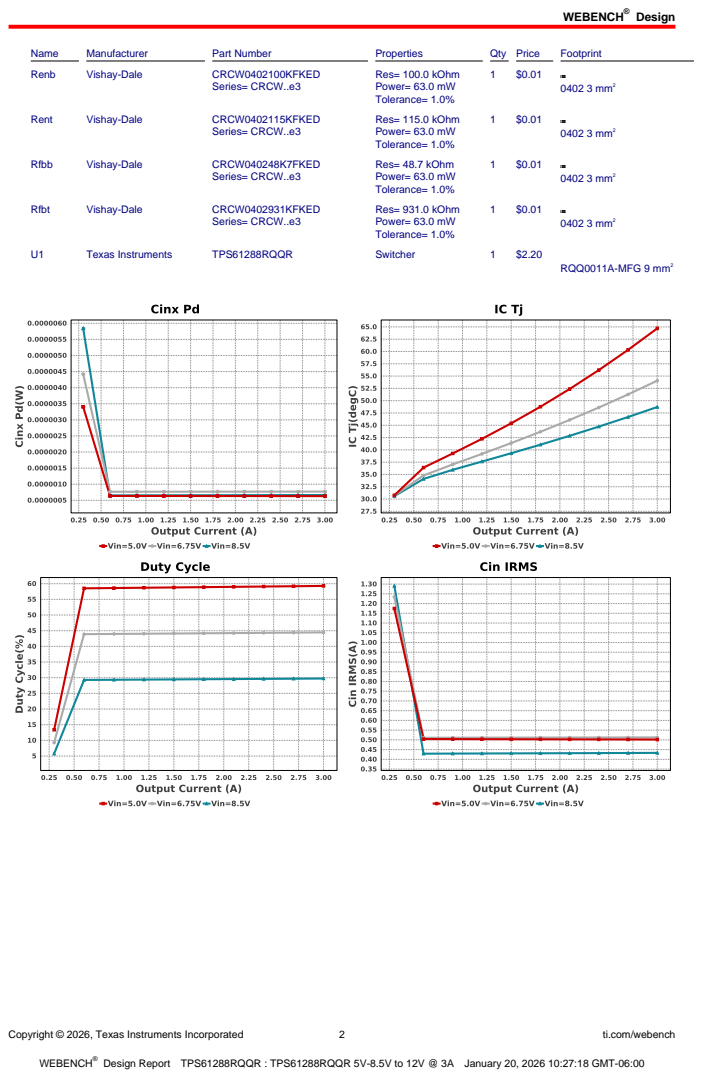
[picture p40: page 2]
Design; Copyright © 2026, Texas Instruments Incorporated; ti.com/webench; Name; Manufacturer; Part Number; Properties; Qty Price; Footprint; Renb; Vishay-Dale; CRCW0402100KFKED; Series= CRCW..e3; Res= 100.0 kOhm Power= 63.0 mW Tolerance= 1.0%; 0402 3 mm²; Rent; CRCW0402115KFKED; Res= 115.0 kOhm Power= 63.0 mW Tolerance= 1.0%; Rfbb; CRCW040248K7FKED; Res= 48.7 kOhm Power= 63.0 mW Tolerance= 1.0%; Rfbt; CRCW0402931KFKED; Res= 931.0 kOhm Power= 63.0 mW Tolerance= 1.0%; Texas Instruments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

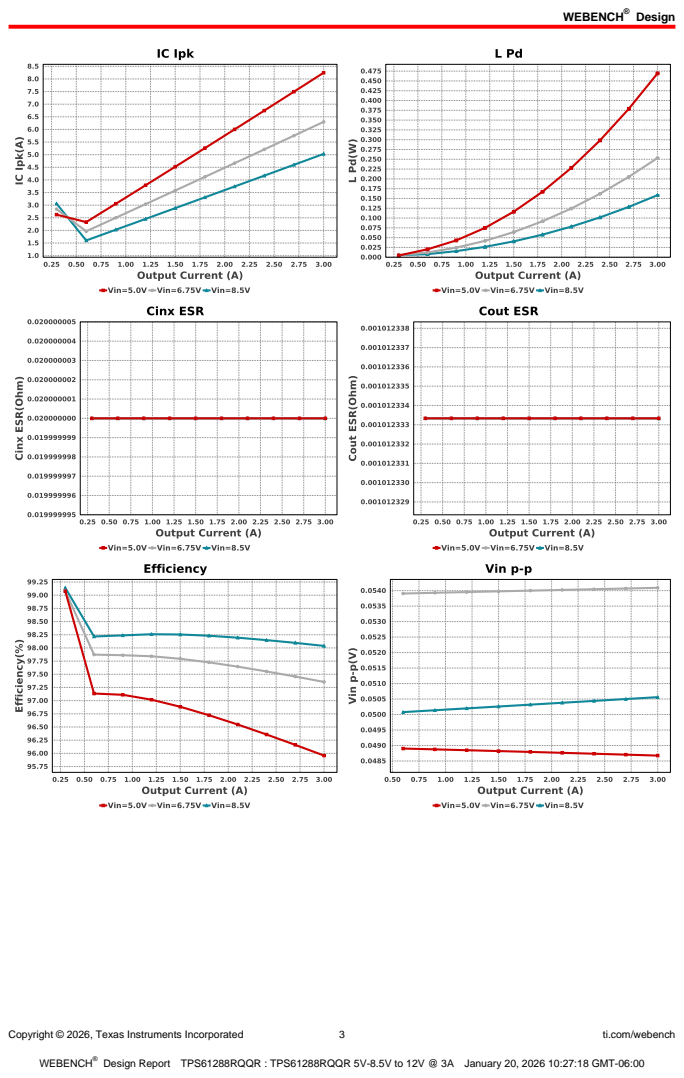
[picture p41: page 3]
Copyright © 2026, Texas Instruments Incorporated; ti.com/webench

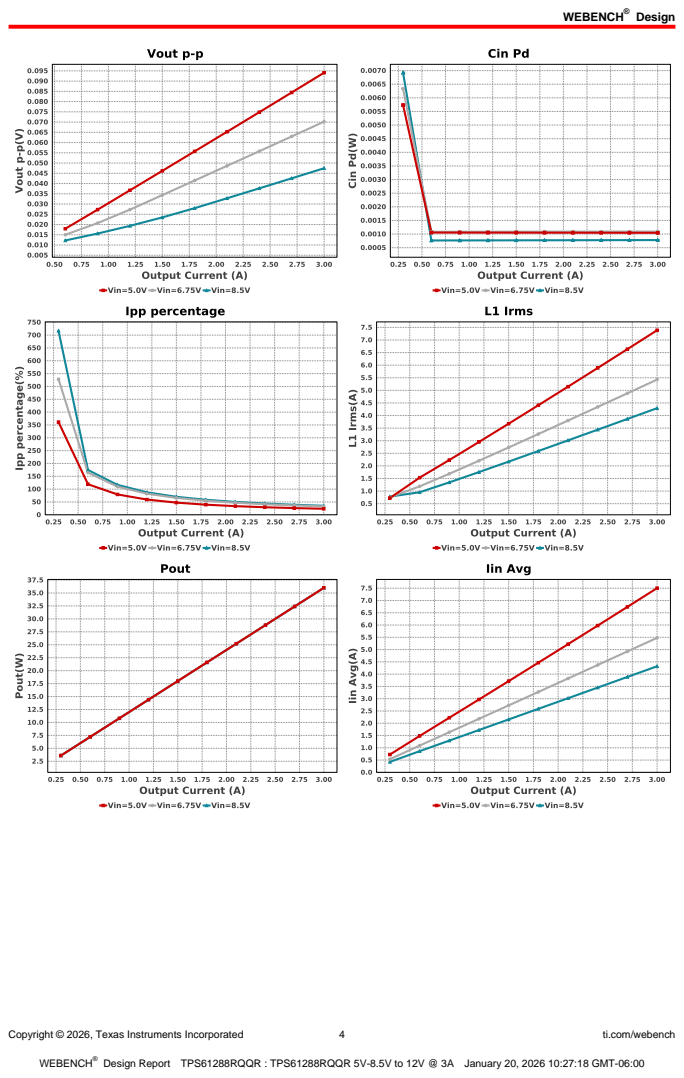
[picture p42: page 4]
Copyright © 2026, Texas Instruments Incorporated; ti.com/webench

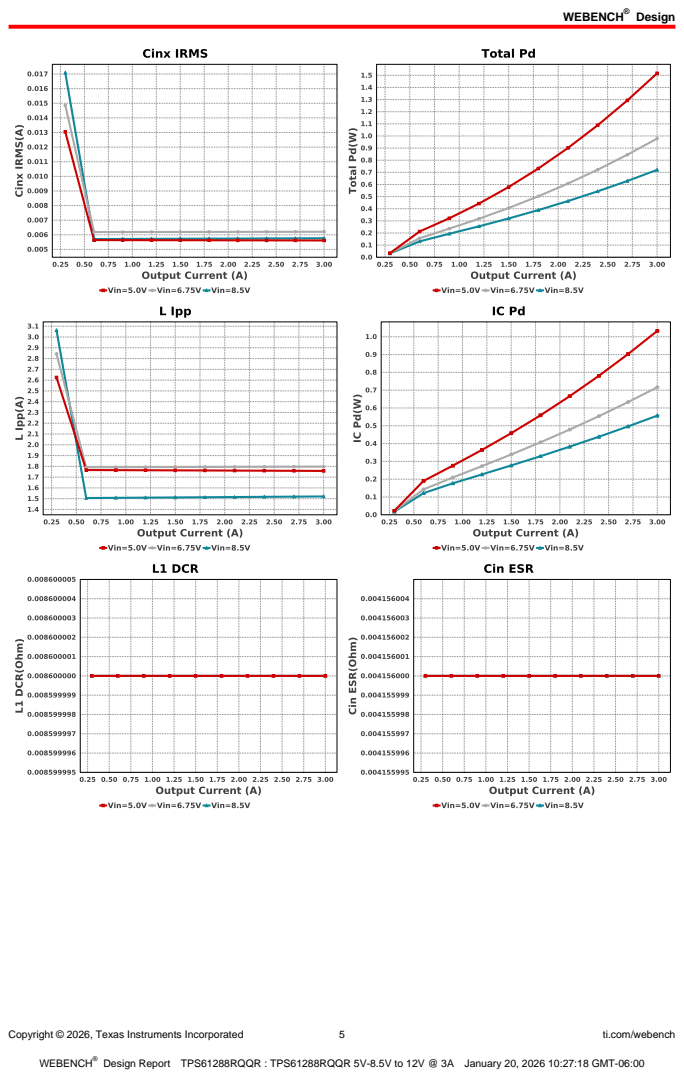
[picture p43: page 5]
Copyright © 2026, Texas Instruments Incorporated; ti.com/webench

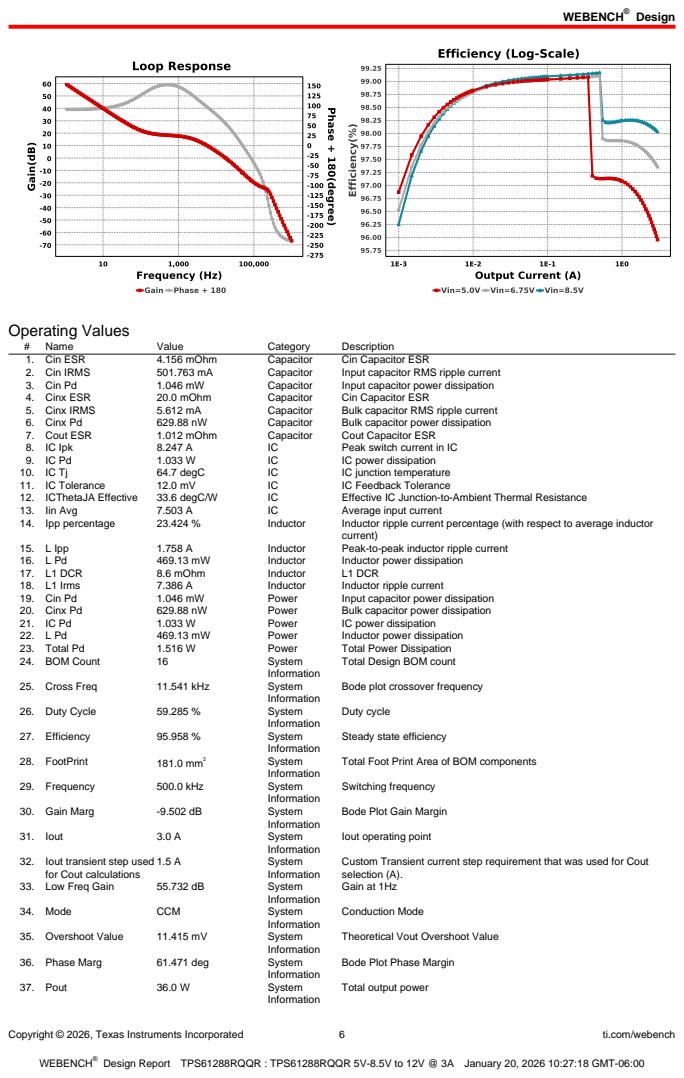
[picture p44: page 6]
Copyright © 2026, Texas Instruments Incorporated; ti.com/webench; Operating Values; Name; Value; Category; Description; 1. Cin ESR; 4.156 mOhm; Capacitor; Cin Capacitor ESR; 2. Cin IRMS; Input capacitor RMS ripple current; 3. Cin Pd; Input capacitor power dissipation; 4. Cinx ESR; 20.0 mOhm; 5. Cinx IRMS; Bulk capacitor RMS ripple current; 6. Cinx Pd; Bulk capacitor power dissipation; 7. Cout ESR; 1.012 mOhm; Cout Capacitor ESR; 8. IC Ipk; Peak switch current in IC; IC power dissipation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

Total Design BOM count

Bode plot crossover frequency

Steady state efficiency

Total Foot Print Area of BOM components

Bode Plot Gain Margin

Iout operating point

32. Iout transient step used
for Cout calculations

Custom Transient current step requirement that was used for Cout
selection (A).
Gain at 1Hz

Theoretical Vout Overshoot Value

Bode Plot Phase Margin

Total output power

Copyright © 2026, Texas Instruments Incorporated | 7 | ti.com/webench
# | Name | Value | Category | Description

38. Total BOM | $4.16 | System
| | | Information | Total BOM Cost
39. Undershoot Value | 12.302 mV | System
| | | Information | Theoretical Vout Undershoot Value
40. Vin | 5.0 V | System
| | | Information | Vin operating point
41. Vin p-p | 48.675 mV | System
| | | Information | Peak-to-peak input voltage
42. Vout | 12.07 V | System
| | | Information | Operational Output Voltage
43. Vout Actual | 12.07 V | System
| | | Information | Vout Actual calculated based on selected voltage divider resistors
44. Vout Ripple
| requirement used for Cout calculations | 1.0 % | System Information | Custom maximum output ripple requirement that was used for Cout selection(% of Vout).
45. Vout Tolerance | 3.958 % | System
| | | Information | Vout Tolerance based on IC Tolerance (no load) and voltage divider resistors if applicable
46. Vout p-p | 94.092 mV | System
| | | Information | Peak-to-peak output ripple voltage
47. Vout transient
| requirement used for Cout calculations | 3.0 % | System Information | Custom Transient voltage change requirement that was used for Cout selection (% of Vout).

## Design Inputs

Name | Value | Description
Iout | 3.0 | Maximum Output Current
VinMax | 8.5 | Maximum input voltage
VinMin | 5.0 | Minimum input voltage
Vout | 12.0 | Output Voltage
| base_pn | | TPS61288 | Base Product Number
source | DC | Input Source Type
Ta | 30.0 | Ambient temperature


Copyright © 2026, Texas Instruments Incorporated | 8 | ti.com/webench

## Assembly

## Component Testing

Some published data on components in datasheets such as Capacitor ESR and Inductor DC resistance is based on conservative values that will guarantee that the components always exceed the specification. For design purposes it is usually better to work with typical values. Since this data is not always available it is a good practice to measure the Capacitance and ESR values of Cin and Cout, and the inductance and DC resistance of L1 before assembly of the board. Any large discrepancies in values should be electrically simulated in WEBENCH to check for instabilities and thermally simulated in WebTHERM to make sure critical temperatures are not exceeded.

## Soldering Component to Board

If board assembly is done in house it is best to tack down one terminal of a component on the board then solder the other terminal. For surface mount parts with large tabs, such as the DPAK, the tab on the back of the package should be pre-tinned with solder, then tacked into place by one of the pins. To solder the tab town to the board place the iron down on the board while resting against the tab, heating both surfaces simultaneously. Apply light pressure to the top of the plastic case until the solder flows around the part and the part is flush with the PCB. If the solder is not flowing around the board you may need a higher wattage iron (generally 25W to 30W is enough).

## Initial Startup of Circuit

It is best to initially power up the board by setting the input supply voltage to the lowest operating input voltage 5.0V and set the input supply's current limit to zero. With the input supply off connect up the input supply to Vin and GND. Connect a digital volt meter and a load if needed to set the minimum Iout of the design from Vout and GND. Turn on the input supply and slowly turn up the current limit on the input supply. If the voltage starts to rise on the input supply continue increasing the input supply current limit while watching the output voltage. If the current increases on the input supply, but the voltage remains near zero, then there may be a short or a component misplaced on the board. Power down the board and visually inspect for solder bridges and recheck the diode and capacitor polarities. Once the power supply circuit is operational then more extensive testing may include full load testing, transient load and line tests to compare with simulation results.

## Load Testing

The setup is the same as the initial startup, except that an additional digital voltmeter is connected between Vin and GND, a load is connected between Vout and GND and a current meter is connected in series between Vout and the load. The load must be able to handle at least rated output power + 50% ( 7.5 watts for this design). Ideally the load is supplied in the form of a variable load test unit. It can also be done in the form of suitably large power resistors. When using an oscilloscope to measure waveforms on the prototype board, the ground leads of the oscilloscope probes should be as short as possible and the area of the loop formed by the ground lead should be kept to a minimum. This will help reduce ground lead inductance and eliminate EMI noise that is not actually present in the circuit.

## Design Assistance

1. Master key : B3BF00BF1E0648B21B0AEEB87FB777AD[v1]
2. TPS61288 Product Folder : https://www.ti.com/product/TPS61288 : contains the data sheet and other resources.

Copyright © 2026, Texas Instruments Incorporated | 9 | ti.com/webench

Important Notice and Disclaimer

TI provides technical and reliability data (including datasheets), design resources (including reference designs), application or other design advice, web tools, safety information, and other resources AS IS and with all faults, and disclaims all warranties. These resources are intended for skilled developers designing with TI products. You are solely responsible for (1) selecting the appropriate TI products for your application, (2) designing, validating and testing your application, and (3) ensuring your application meets applicable standards, and any other safety, security, or other requirements.

These resources are subject to change without notice. TI grants you permission to use these resources only for development of an application that uses the TI products described in the resource. Other reproduction and display of these resources is prohibited. No license is granted to any other TI intellectual property right or to any third party intellectual property right. TI disclaims responsibility for, and you will fully indemnify TI and its representatives against, any claims, damages, costs, losses, and liabilities arising out of your use of these resources.

Providing these resources does not expand or otherwise alter TI's applicable Terms of Sale or other applicable terms available either on ti.com or provided in conjunction with TI products.
