Mouse-Unit-07/hardware-motherboard/layout/mouse-unit-07-layout-B.pdf

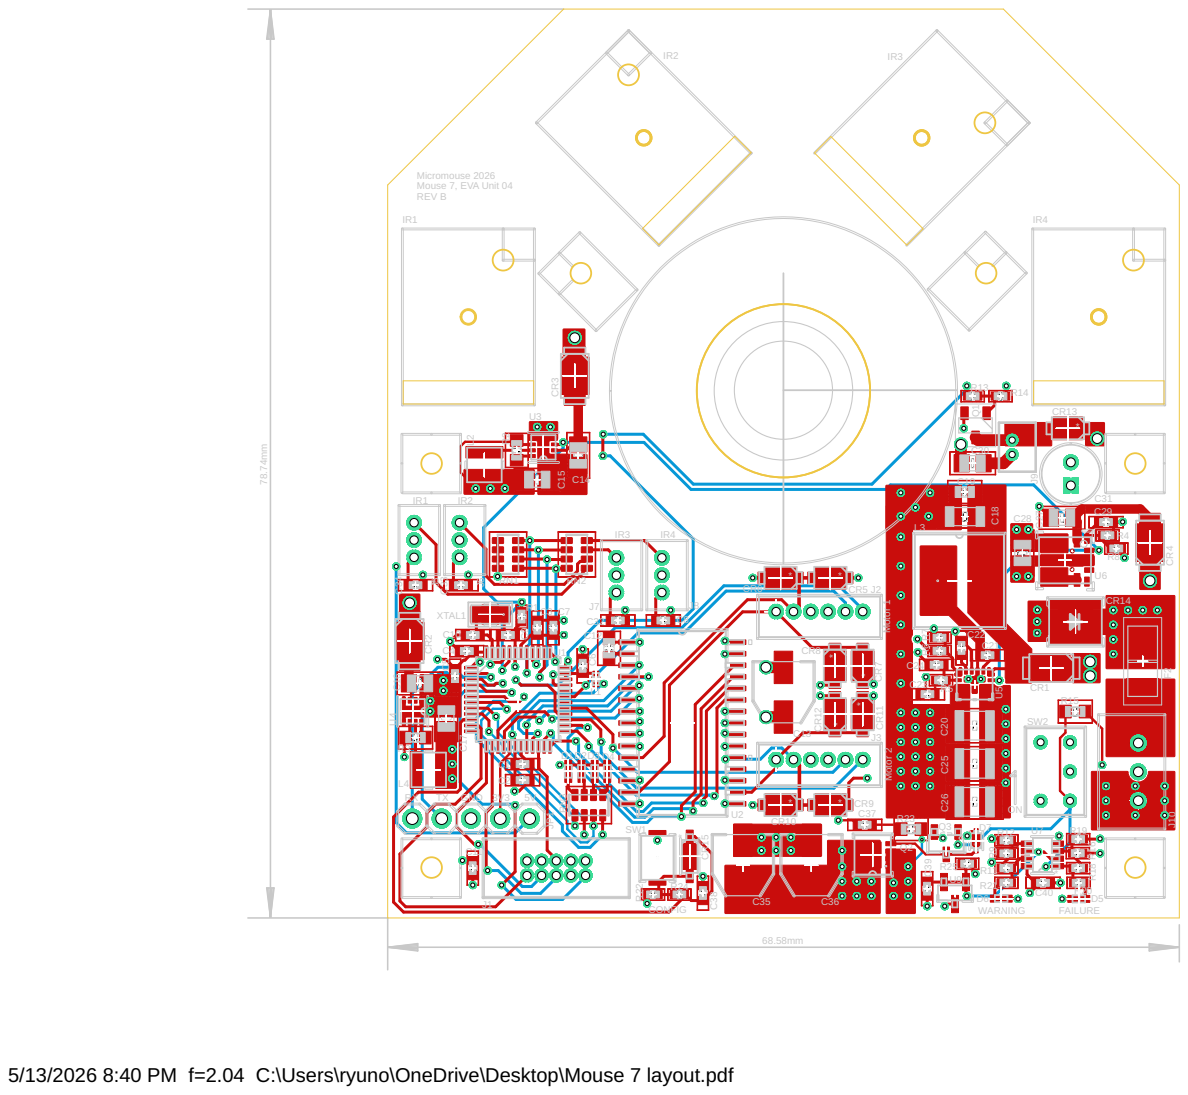
[picture p50: page 1]

Micromouse 2026 Mouse 7, EVA Unit 04 REV B

5/13/2026 8:40 PM f=2.04 C:\Users\ryuno\OneDrive\Desktop\Mouse 7 layout.pdf
