Mouse-Unit-07/hardware-motherboard/(commit log)

2025-04-27 docs: fix power-explanation markdown for total current
2025-04-27 docs: add bill of materials
    [motherboard-BOM.csv]
2026-01-20 docs: add simple power tree diagram
2026-01-21 docs: fix colors on power tree diagram
2026-05-07 docs: add new rev B BOM, layout, schematic, and design explanations
    [motherboard-BOM.csv]
2026-05-11 docs: move all 3d modeling notes and files to 3d mechanical parts repo
    [Battery Mount- 450mAh LiPo.3mf, sharp sensor mount.3mf, vacuum fan.3mf, vacuum motor mount.3mf, wheel mount gears- large gear.3mf, wheel mount gears- small gear.3mf, wheel mount- left.3mf, wheel mount- right.3mf]
2026-05-14 docs: update documentation for fixed power management rev b motherboard
    [motherboard-BOM.csv]
2026-05-21 docs: add new ir sensor piecewise modeling documentation
2026-06-17 docs: add motor drift documentation
